williamsu0707/NTOU-UAV-Wind-Measurement-System/Document/Project Report.pdf

# 國立台灣海洋大學

## 通訊與導航工程學系

## 專題研究報告

### 指導教授:莊季高教授

# 不同風速下校園風場數值

# 模擬與實體量測對比分析

## 學生：林哲宇、蘇意為 撰

## 中華民國 114 年 11 月

摘要

### 本研究旨在解決國立臺灣海洋大學理工科系在無人機飛行與應用研究中，對校

### 園微氣候風場數據缺乏經驗證、可靠數值的實務痛點。透過整合數值模擬與高

### 機動性實測，本專題目標為評估 OpenFOAM 搭配 紊流模型在不同風速工況下

### 的預測可靠度，並提供一套實用的模擬基準。

### 在方法論上，我們使用 Blender 和 blosm 插件建立校園建築群的精確幾何模

### 型，並將 yPlus 值處於極高範圍的挑戰，視為硬體限制下的工程取捨。實測部

### 分則採用四軸旋翼無人機搭載高精度感測器，針對 2 級、 3 級、4 級風三種工

### 況，各進行了三次獨立的重複測量，以確保數據的統計嚴謹性與可重複性。

### 結果顯示： 經由空間對齊與 RMSE 相關係數的定量對比，OpenFOAM 模型在

### 中度風速下表現最佳。其中，3 級風工況的模擬數值與實際測量的趨勢相近，

### 證明了模型在宏觀流場趨勢預測上的可參考性。然而，在 2 級風工況下，模擬

### 數值顯著增高，這主要歸因於 RANS 模型的固有局限性以及近壁面 yPlus 極限

### 的影響。

### 本研究結論： 模型在中度風速下具有顯著的工程應用價值。本專題成果為海洋

### 大學理工科系提供了一套經實測校準的 CFD 模擬操作基準，直接降低了無人

### 機飛行優化所面臨的風場未知影響。

### 關鍵詞：OpenFOAM、CFD、無人機量測、k − ω SST 、RMSE、yPlus

目錄

## 圖目錄

## 表目錄

## 第一章 緒論

## 1.1 研究動機

### 在挑選專題時，我們思考了許久遲遲想不到要做什麼主題，在指導教

### 授的建議下，我們找了碩班的學長聊聊，在因緣際會之下我們得知了，原

### 來風場的不同會造成無人機電池的使用時間，也會影響到 PID 的參數，於

### 是我們就想知道有沒有什麼辦法，可以不用每次都去測量風速就能知道實

### 際的風場數值，於是學長跟我們介紹了一個開源軟體 OPENFOAM，它可

### 以很好的模擬及呈現假設風流進來會有什麼樣的變化。

### 但是我們遇到了一個問題，數值模擬的結果並不一定是完全跟現實情

### 況相符的，需要有實際測量的數據來佐證，模擬結果也可能因為模型設定

### 或邊界條件的不同而出現誤差，特別是在建築物密集、氣流變化劇烈的邊

### 界層區域中誤差會變得更為嚴重。因此，我們這項研究的主要目的，就是

### 要了解「模擬」與「實際」之間的差距。

### 我們決定使用 Blender 來建立校園建築的立體模型，接著利用先前提

### 到的 OpenFOAM 進行風場數值模擬，並加入無人機進行風速及風向的測

### 量。透過這樣的方式，我們能得到更加接近現實情況的數據，也能以多風

### 速、多次重複的實測數據來驗證模擬的準確性，進一步了解 OpenFOAM

### 在模擬實際校園環境中的可靠度。最後，我們希望能得到一套經過實測的

### 可信的模擬基準，讓未來進行相關研究時，能把 OpenFOAM 這個程式做為

### 可以信任的模擬軟體，使未來的研究增加一個可以選擇或參考的方式。

### 由於海洋大學的校園鄰近海邊，風場變化快速而且複雜，這讓準確的

### 風場資料顯得特別重要。許多研究領域，像是無人機飛行控制、風能發電

### 設備的部署、大氣污染擴散模擬，都需要比較精確地風速與風向資訊。當

### 風速從二級（輕風）上升到四級（和風）時，氣流的分離位置、渦流形成

### 以及紊流強度也都會有明顯的變化，我們希望能透過這個專題，利用多種

### 風速條件下的實測數據來驗證數值模型，來驗證這種風場模擬方法是不是

### 可信的，為未來的研究提供依據。

## 1.2 研究目的

### 本研究的目的是結合數值模擬與高精確度無人機的實地測量，來評量

### OpenFOAM 在模擬海洋大學校園內特定建築群間，風在不同速度下流動時的準

### 確性，並建立一個可供研究參考的基礎。

### 首先會使用 Blender 軟體，依照實際尺寸建立校園的完整立體建築模型，

### 作為後續 OpenFOAM 模擬的基礎資料。接著在 OpenFOAM 軟體上設定適當

### 的紊流模型與網格策略，設定 2 級、3 級與 4 級風速三種不同情境進行定常

### 流場模擬，取得校園內風速與風向的立體分布結果。

### 為了驗證模擬的可靠度，我們選定了幾棟建築物，在建築物周圍利用無人

### 機在實地實測。無人機會在選定的建築物周圍以 10 公尺為一個級距，在三種風

### 速條件下各進行三次測量，利用搭載的風向風速器收集實際的風場數據，透過

### 樹莓派獲得即時數據，確保結果具有統計代表性。

### 在資料分析時，我們會將模擬結果與三次實測的平均值進行空間上的對

### 應，並透過 均方根誤差（RMSE）、平均絕對誤差（MAE） 以及 相關係數

### （R） 來計算並且以數值來呈現兩者的差異性與一致性。

### 最後，根據比較結果，我們將探討模型在不同風速下的誤差來源，並提出

### 改進 OpenFOAM 模型參數與操作流程的具體建議。希望能將這些成果作為海

### 洋大學理工相關科系的學生們進行風場或微氣候模擬時的參考。

## 1.3 研究材料及方法

### 本研究之研究流程(圖 1)及所使用之主要材料與設備含各項主要元件(圖 2~圖

11):

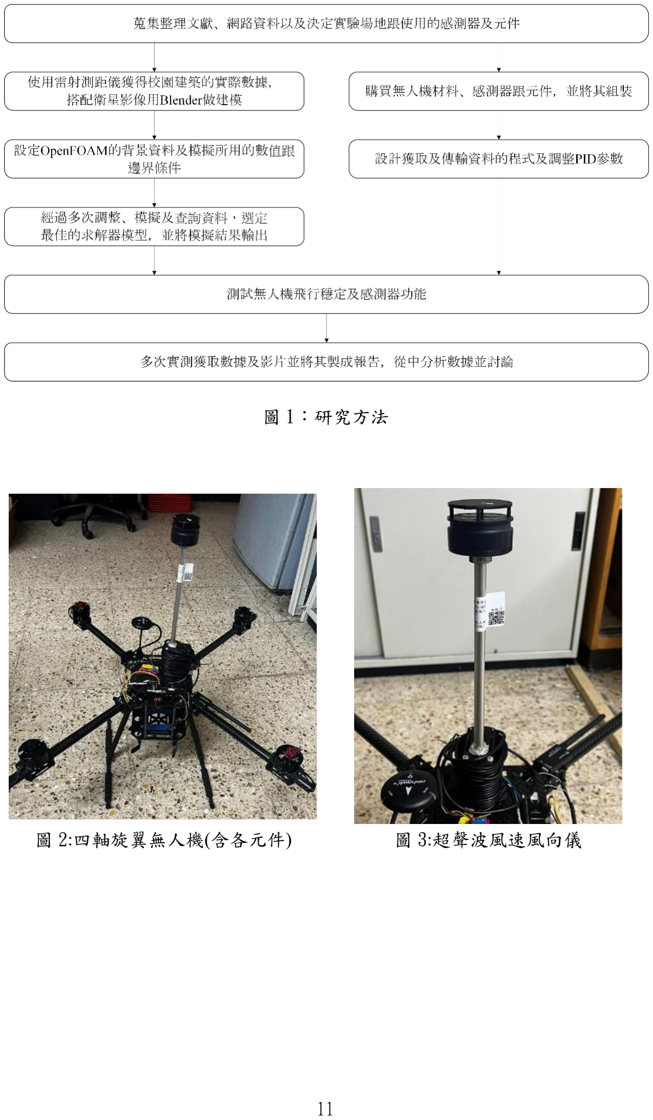
[picture p6: page 11]

### 圖 1：研究方法

圖 2:四軸旋翼無人機(含各元件) | 圖 3:超聲波風速風向儀

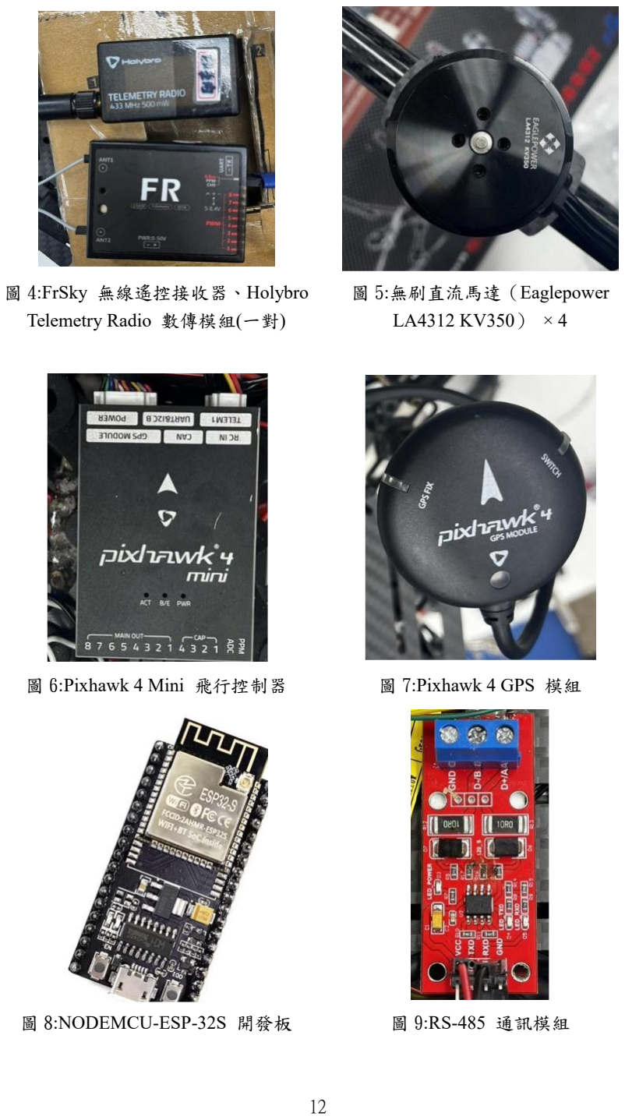
[picture p7: page 12]

圖 4:FrSky 無線遙控接收器、Holybro
Telemetry Radio 數傳模組(一對)

圖 5:無刷直流馬達（Eaglepower
LA4312 KV350） × 4
圖 6:Pixhawk 4 Mini 飛行控制器 | 圖 7:Pixhawk 4 GPS 模組
圖 8:NODEMCU-ESP-32S 開發板 | 圖 9:RS-485 通訊模組

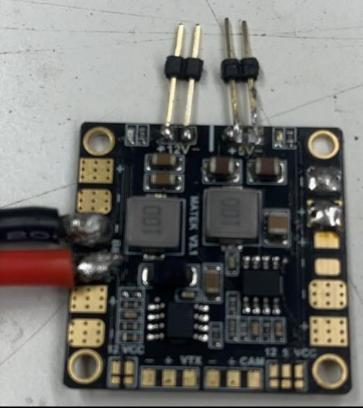
[picture p8: figure]
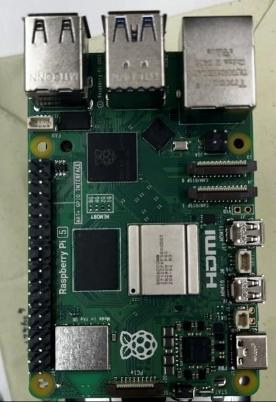
[picture p9: figure]

圖 10:Raspberry Pi 5 | 圖 11:Mini Power Hub(分電板)

## 1.3.1 主要元件規格及其用途:

ESP-32S

### 1. 參數規格[2]

- 模組型號：NodeMCU-32
- 尺寸：25.4mm(W)*48.3mm(H)±0.2mm
- 封裝：DIP-38(2.54 間距標準排針)
- SPI FLASH：默認 32 Mbits
- 支持接口：UART/SPI/SDIO/I2C/PWM/I2S/IR/ADC/DAC
- 頻率範圍：24002483.5λMHz
- 串口速率：支持 300~4608000bps,默認 115200bps
- 藍牙：藍牙 4.2BR/EDR 和 BLE 標準
- SPI Flash：默認 32Mbit,最大支持 128Mbit
- 工作溫度：-20℃70℃
- 存儲環境：-40℃~125℃，<90%RH

### - 供電範圍：

- Micro USB 供電電壓 4.75V5.25V,推薦 5.0V
- 供電電壓 3.0V~3.6V,供電電流>500mA,推薦 3.3V
2. 用途

### - 作為通訊層核心微控制器。

- 透過 MAX485 模組與超音波風速風向儀進行 Modbus RTU 通 訊。

### - 定期以 RS-485 發送查詢指令並接收風速／風向資料。

- 將解析後的資料封裝為 JSON 字串經 UART（115200 bps）傳送

至 Raspberry Pi 5。

### - 作為感測器與主控層之間的資料「轉換節點」。

RS-485 模組

### 1. 參數規格[3] - 晶片具有限擺率驅動程式，減少 EMI，並減少由不恰當的終端匹配 線纜引起的信號反射，從而使無差錯信號傳輸率高達 500Kbps。 - 訊號形式：差動訊號（A / B 線）

- 邏輯電平：TTL（與 ESP-32S UART 電平相容）

### - 具有 1/4 單位負載的接收器輸入阻抗，支援多機通訊，允許接在不 超過 128 個設備的匯流排上 - 工業級晶片工作溫度可以達到-40℃至+85℃。 - 具有電源和 RXD、TXD 信號指示燈

- 支援 3.3V 和 5V 信號控制
2. 用途

### 本研究採用的 RS-485 轉換模組以 MAX485 晶片為核心，用於 將超音波風速風向儀所輸出的 RS-485 差動訊號轉換為 ESP-32S 可 讀取之 UART 電平訊號。由於超音波風速風向儀採用 Modbus RTU 協定，且使用 半雙工 RS-485 作為實體層，因此必須透過 MAX485 進行電氣層介面轉換與方向控制，才能與 ESP-32S 正確通訊。 MAX485 模組之於本系統的用途如下： (1) 進行 RS-485 → UART 電氣層轉換（感測器 → ESP-32S） - 超音波風速風向儀以 RS-485 差動訊號輸出量測資料，ESP-

32S 僅支援 UART（TTL 電平）
- MAX485 負責將 RS-485 A/B 差動訊號轉換為單端 UART 訊 號（RO → ESP-32S RX）
- 同時將 ESP-32S 的 UART 傳送訊號（TX → DI）轉換為 RS-485 差動訊號（A/B）

### - 確保感測資料能在兩種不同電氣標準間正確傳輸 (2) 提供 UART → RS-485 的查詢指令（ESP-32S → 風速儀） ESP-32S 程式碼會主動發送：

node.readHoldingRegisters(0x0001, 1);

### 此指令會：

- 由 ESP-32S 透過 UART TX 輸出查詢封包
- 經 MAX485 的 DI 腳位轉成 RS-485 差動訊號（A/B）

### - 傳送到風速儀（Slave）

因此 MAX485 是 ESP-32S 能進行 Modbus 查詢的必要模組。

### (3) 處理半雙工通訊的方向切換（DE/RE） RS-485 以半雙工方式運作，需要於「傳送模式」與「接收模式」

### 間切換。

MAX485 的 DE/RE 腳位提供此切換功能：

### - DE/RE＝HIGH → 進入傳送模式（主站查詢風速儀） - DE/RE＝LOW → 進入接收模式（等待回應封包） 此機制確保 Modbus RTU 的查詢與回應不互相衝突，是本研究通 訊流程能穩定運作的關鍵。 (4) 提供差動訊號之抗干擾能力，適用於無人機工作環境

- RS-485 差動訊號具備高抗 EMI 能力

### - 可有效抑制無人機上馬達、ESC、高電流線路所產生的噪聲 - 即使在振動與動態電磁干擾環境中，仍能維持穩定、可靠的資 料傳輸 (5) 作為感測層與通訊層之間的訊號穩定化橋接模組

MAX485 負責整合：
- 風速風向儀（RS-485）
- ESP-32S（UART）

### 確保感測資料以正確的電氣格式傳輸至通訊層， 並為後續資料解析與數據封裝提供穩定來源。

Raspberry Pi 5

### 1. 參數規格[4]

- 處理器：Broadcom BCM2712，64 位元四核心 Arm Cortex‑A76，

### 時脈 2.4 GHz，內建加密擴充，每核心 512 KB L2 快取，2 MB 共用 L3 快取。

- 圖形處理器：VideoCore VII GPU，支援 OpenGL ES 3.1 與 Vulkan 1.2，具 800 MHz 時脈，並內建 4Kp60 HEVC 解碼能力。

### - 顯示輸出：雙 HDMI，可支援 4Kp60 螢幕顯示，並具備 HDR 支

援。
- 記憶體：LPDDR4X‑4267 SDRAM，提供 2GB, 4GB, 8GB 和

### 16GB 容量選項。

- 網路無線功能：雙頻 802.11ac Wi‑Fi（Wi‑Fi 5），以及藍牙 5.0／低

### 功耗藍牙（BLE）。 - 儲存與擴充性： - microSD 卡插槽，支援高速 SDR104 模式（效能為前代的兩倍）。 - 提供單條 PCIe 2.0 ×1 插槽，可搭配 M.2 HAT 或其他轉接板，連 接高頻寬外設。

- USB 接口：2 × USB 3.0（同時支援 5 Gbps 傳輸），及 2 ×
USB 2.0。
- 以太網路與 PoE 支援：千兆乙太網路（Gigabit Ethernet），支援

PoE+（需另購 PoE+ HAT）。

### - MIPI 接口：2 × 四通道（4‑lane）MIPI 攝影機／顯示器收發器， 帶寬為先前兩條 1 Gbps 接口的三倍，可支援任意兩個攝影機或顯 示設備組合。

- 電源：5V/5A DC，透過 USB‑C 提供，支援 Power Delivery。
- GPIO：標準 Raspberry Pi 40‑pin 接頭（向後相容）。

### - 其他功能：內建實時時鐘（RTC，需外部電池供電）與電源開關按

鈕
2. 用途
Raspberry Pi 5 在本研究中作為 主控層（Processing Layer）

### 負責 ESP-32S 傳回資料的接收、資料處理、資料記錄與視覺化網頁服 務之提供，是整體系統中最核心的資料管理平台。 (1) 作為主控層資料處理核心

- 以 USB-to-Serial 介面（115200 bps）接收 ESP-32S 所傳送的

### JSON 格式風速／風向資料 - 使用 Python（pySerial）解析每筆資料並存入記憶體緩衝區 - 執行資料有效性檢查（防空讀取、不完整 JSON 濾除） - 將「最新數據」存放於系統共用變數以供網頁查詢 (2) 執行資料統計與長期儲存 Raspberry Pi 5 負責以背景執行緒定期處理感測資料： - 每分鐘計算一次平均風速與平均風向 - 自動建立每日 CSV 檔案（依日期命名） - 儲存完整的時間戳記、平均風速、平均風向資料 - 作為風場長期監測及後續分析之數據來源

(3) 建立即時資料伺服器（Flask Web Server） Raspberry Pi 5 使用 Flask 建立本研究的前端服務：
- /data：提供最新風速（m/s）與風向（°）之 JSON API
- /：提供視覺化網頁（Chart.js）

### - 允許其他裝置透過同網域 IP 直接瀏覽即時資料（例如手機、筆

電）

### 此架構讓使用者可即時查看無人機載測風場之即時資訊。 (4) 提供資料整合與系統管理功能 - 自動偵測本機 IP，顯示系統網址以供快速瀏覽 - 負責管理背景執行緒（感測器輪詢、資料儲存） - 整合感測層與顯示層的所有資料流程 - 作為整個無人機風場量測系統的主要運算平台 (5) 作為感測層與顯示層之間的資料橋接節點

Raspberry Pi 5 扮演資料中樞（Data Hub）角色，負責：

### - 接收來自 ESP-32S（通訊層）的風速／風向資料 - 將資料整理為標準化格式 - 轉換為網路可讀格式（JSON） - 提供瀏覽器端即時視覺化 使整個系統能從無人機端一直到使用者端保持資料同步與一致性。

## 第二章 系統架構設計

## 2.1 系統架構設計

### 本研究所建置之「無人機風場即時量測系統」由感測層、通訊層、主控層 及顯示層組成，其整體架構如(圖 12) 所示。系統架構旨在於無人機飛行過程 中持續獲取風速與風向資料、即時傳輸至地端運算平台，並透過網頁介面進行 視覺化呈現。

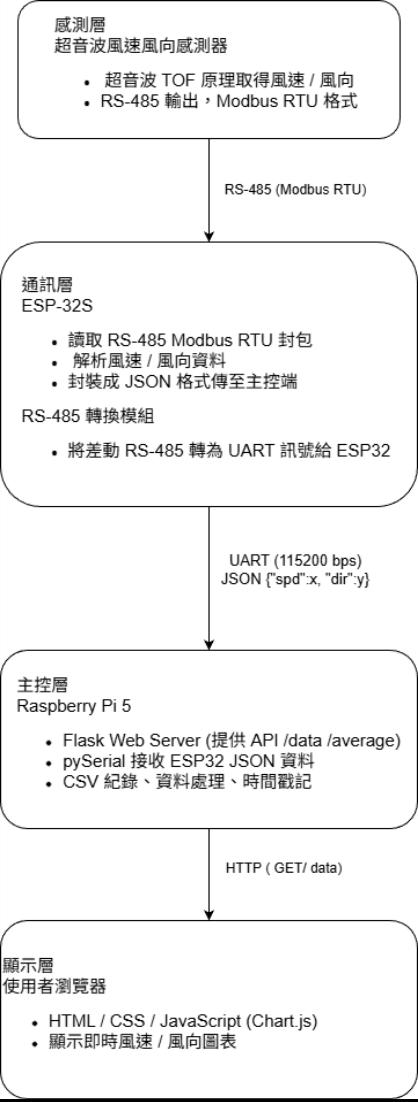
[picture p10: figure]

### (圖 12:系統架構流程圖)

### 2.1.1 感測層

### 感測層使用超音波風速風向感測器 進行環境風場量測，由一顆 4000 mAh 6S 的電池供電。 該感測器採用 超音波飛行時間差（Time of Flight, ToF） 原理，能同時提 供瞬時風速（m/s）與風向（°）資訊，並以 RS-485 介面輸出 Modbus RTU 格 式之資料。 感測器主要規格如下[1]

項目 | 規格內容
量測範圍 | 風速：0–60 m/s；風向：0–359°
量測精度 | 風速：±3%；風向：±3°
分辨率 | 風速：0.1 m/s；風向：1°
感測器尺寸 | 直徑 50 mm；高度 50 mm
重量 | 56 g
輸出介面 | RS-485
通訊協定 | Modbus RTU / ASCII
波特率 | 4800–19200 bps（可設定）
電源需求 | VDC：5-30V； 15mA(12V)
操作溫度/濕度 | −40°C ～ +70°C；0–100 %
工作海拔 | 0–4000 m
安裝方式 | 飛行器頂部立住安裝或底部吊裝
外殼材質 | ABS/黑色

### (表 1：風速計規格)

### 2.1.2 通訊層

### 通訊層負責將感測層取得之風速與風向資料可靠地傳輸至主控層，是本系 統中確保量測資料穩定性與正確性的核心架構。本研究之通訊層由 RS-485 轉 換模組（MAX485） 與 ESP-32S 微控制器 所組成，分別負責差動訊號之電氣 轉換、Modbus RTU 通訊、資料解析與重新封裝等功能。RS-485 模組的供電來 源跟風速儀是同一顆電池供電，由 Mini Power Hub 分電分成 12V 與 5 V 使

用。

### 本研究使用之超音波風速風向儀以 RS-485 差動式訊號並遵循 Modbus RTU 協定輸出資料。由於 ESP-32S 僅支援 UART（TTL 電平），故需透過 MAX485 模組將 RS-485 差動訊號轉換為 UART 單端訊號，使微控制器能正 確讀取感測器之回應封包。

ESP-32S 於通訊過程中擔任 Modbus RTU 主站（Master），定期發送 Function Code 0x03（Read Holding Registers） 之查詢指令，以讀取風速與風向

### 所屬之寄存器資料。查詢前透過控制 MAX485 之 DE/RE 腳位切換至傳送模 式，待封包送出後則切換回接收模式以讀取感測器回應資料。此方向切換機制 為 RS-485 半雙工通訊之必要條件，可確保查詢與回應封包不互相干擾。 ESP-32S 接收到感測器回應後，會解析寄存器內容，並將風速（m/s）與風 向（°）轉換為浮點數格式。解析完成後，ESP-32S 會將資料封裝為 JSON 字

串，並透過模組內建之 USB-to-Serial（USB CDC）介面，以 115200 bps 傳送

### 至 Raspberry Pi 5，由主控層進行後續資料處理與儲存。 之所以選擇 RS-485 作為感測層與通訊層之間的資料傳輸介面，基於以下

原因：

### 1. 較強的抗干擾能力 RS-485 採差動訊號傳輸，具備強大的 EMI 抑制能力，特別適用於無 人機環境中因馬達、電子調速器（ESC）與高電流電源所造成之電磁雜訊。 2. 可靠之長距離與工控等級通訊能力 RS-485 可支援數十至數百公尺的傳輸距離，即使本研究中線長不長， 其高可靠特性仍可確保資料穩定性。 3. 符合 Modbus RTU 之工業標準實體層

風速風向儀採 Modbus RTU 作為通訊協定，而 RS-485 為 Modbus
RTU | 最常見之實體層，有利於減少協定實作複雜度並提高系統穩定
性。

### 4. 降低地電位差與提升電氣安全性

| 差動訊號具備較低電壓擺幅，可有效降低地環路問題並提升系統整

### 體可靠度。 綜合以上設計，本研究通訊層採用

「RS-485（Sensor → ESP-32S）＋ USB Serial（ESP-32S → Raspberry Pi 5）」

### 的雙層資料傳輸架構，兼具工控等級穩定性與即時資料更新能力，確保風速與 風向量測資料能可靠傳遞至主控層。 下圖(圖 13)展示超音波風速風向儀、RS-485 轉換模組（MAX485）、ESP-32S 與 Raspberry Pi 5 之間的電源分配、資料傳遞方向與實體接線關係。無人 機主電池分別供電給 RS-485 模組與風速儀；行動電源提供 Raspberry Pi 運算

電力，而 ESP-32S 透過 USB 與 Raspberry Pi 建立序列通訊並同時獲得 5V 電力。資料自風速儀以 Modbus RTU（RS-485）傳至 ESP-32S，再以 USB Serial 傳至 Raspberry Pi 進行解析與視覺化。

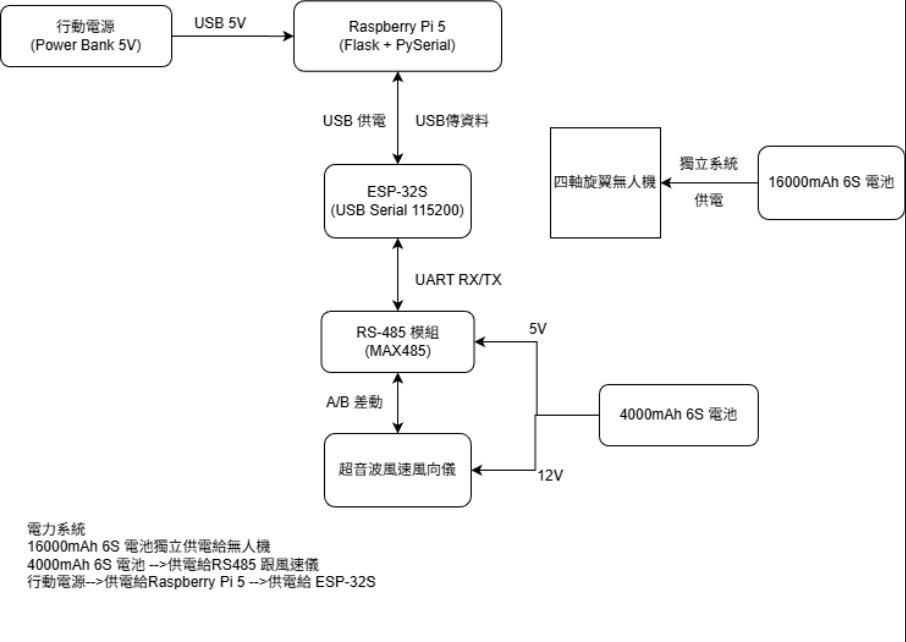
[picture p11: figure]

### (圖 13:硬體接線電力與資料關係圖)

### 2.1.3 主控層

### 主控層由 Raspberry Pi 5 所構成，樹莓派由一顆行動電源供電，負責接收 通訊層所傳遞之風速與風向資料，進行資料解析、緩衝、即時資料更新、統計 計算與資料儲存，並提供資料存取之網路服務。此層整合序列通訊處理、資料 管理與網頁伺服器功能，是整體系統資料整合與呈現的核心單元。

Raspberry Pi 5 透過其 USB 端口與 ESP-32S 連接，並以 USB-to-Serial （USB CDC）方式建立 115200 bps 的序列通訊連線。主控層使用 Python 之

### pySerial 函式庫持續讀取 ESP-32S 所輸出的 JSON 格式資料，並進行解析與 資料驗證。解析成功的資料會即時更新於系統共用變數 last_data 中，並同時推 入採樣緩衝區以供後續統計運算使用。 為避免主程序阻塞與確保資料即時性，主控層採用背景執行緒（Thread） 進行資料輪詢與存檔作業。背景執行緒以高頻率（50 Hz 輪詢）讀取序列埠資 料，並每分鐘自動計算一次平均風速與平均風向。計算結果以 CSV 格式儲 存，依日期自動建立檔案，使系統能進行長期量測紀錄與後續統計分析。

Raspberry Pi 5 並以 Flask Web Framework 建立網頁伺服器，提供資料查詢

### 與前端顯示功能。伺服器提供以下 API： - /data：回傳最新風速（m/s）與風向（°）之 JSON 資料

- /：提供前端視覺化網頁介面（HTML + JavaScript）

### 透過此設計，使用者可於瀏覽器輸入設定好之網址，<樹莓派 IP>:5000 即 可即時查看無人機量測之風場資訊。主控層同時整合 IP 偵測功能，於啟動時 自動顯示本機局域網路 IP，以便使用者快速連線查看資料。 整體而言，主控層負責處理資料接收、解析、平均化、儲存與即時對外服 務等工作，並作為感測層與顯示層之間的資料中樞，使本風場量測系統能於無 人機運作期間提供即時且穩定的風速風向資訊。

### 2.1.4 顯示層

### 顯示層負責將主控層處理後的風速與風向資料以視覺化方式呈現，使使用 者能即時掌握無人機量測到之風場變化。本研究之顯示層採用基於網頁的呈現

方式，主要由 Flask Web Server、HTML 前端介面與 Chart.js 圖表套件所組

### 成。此層提供跨平台、免安裝、低延遲之資料觀測方式，可透過一般桌上型電 腦、筆記型電腦或行動裝置進行查看。 顯示層與主控層之間透過 HTTP 標準介面進行資料交換。Raspberry Pi 5 於主控層中建立 /data API，以 JSON 格式傳送最新風速與風向資料。前端介 面每隔固定時間（約 1 秒）向此 API 發送請求，取得最新風場資訊，並即時 更新於圖表畫面。此方式不需額外安裝應用程式或驅動程式，僅需在瀏覽器中 輸入<樹莓派 IP>:5000 即可使用。

前端視覺化部分由 HTML 與 JavaScript 建構，並使用 Chart.js 作為資料

### 繪圖框架。透過 Chart.js，可將風速變化以折線圖方式即時呈現，而風向資料 則可進行角度轉換後顯示於極座標或儀表式圖形。此視覺化介面可清楚呈現無 人機飛行期間風場的瞬時變化情形，並有助於使用者判讀風況趨勢。

### 顯示層之整體運作流程如下：

1. 前端 JavaScript 定期向 Flask /data API 發送 AJAX 請求

### 2. 主控層回傳最新風速（m/s）與風向（°）資料 3. 前端取得資料後即時更新圖表 4. 使用者透過網頁介面查看風場變化 此架構具備以下優點： - 跨平台性高：可於任何具備瀏覽器的裝置使用 - 即時回饋：資料更新頻率高，延遲極低 - 低成本且易維護：免安裝額外應用程式，部署方式簡單 - 擴充性佳：可新增歷史紀錄查詢、風向玫瑰圖或儀錶板等功能

### 綜合而言，顯示層提供使用者友善且具即時性的視覺化風場數據介面，使 整體系統能有效呈現無人機量測過程中的風速與風向變化情形，並提升系統之 可用性與分析能力。

## 2.2 系統流程

### 本節說明本研究風速風向量測系統自啟動、資料讀取、傳輸、解析、儲存 與視覺化顯示之完整運作流程。系統由感測層、通訊層、主控層與顯示層協同 運作，以確保風場數據能穩定、即時且連續產生。

## 2.2.1 系統啟動與模組初始化

當 ESP-32S 開機後，會首先初始化 USB Serial（供樹莓派接收）、UART2 （用於 RS-485 / Modbus 通訊）、ModbusMaster 物件與 RS-485 方向控制腳位

### （DE/RE）。以下程式碼為 ESP-32S 啟動階段的初始化動作程式碼：

Serial.begin(115200); // 與樹莓派通訊
Serial2.begin(9600, SERIAL_8E1, RXD2, TXD2); // 與風速計通訊：9600, 8E1

node.begin(1, Serial2); // Modbus ID = 1
pinMode(RE_DE, OUTPUT);
digitalWrite(RE_DE, LOW); // 預設為接收狀態
說明：
上述初始化設定包含 USB Serial（115200 bps）、Modbus RTU 參數（9600

### bps、8E1）、RS-485 方向控制腳位設定，確保 ESP-32S 能依序進行查詢與接 收感測器回應。

### 2.2.2 Modbus RTU 查詢流程

### ESP-32S 以 Modbus Master 身分每秒向超音波風速風向儀發送查詢命令 （Function Code 0x03）。研究中讀取的寄存器包含風向（1 寄存器）與風速（2 寄存器）。以下為查詢指令的實際程式碼：

uint8_t result_dir = node.readHoldingRegisters(0x0001, 1);
uint8_t result_spd = node.readHoldingRegisters(0x0002, 2);
說明：

### ESP-32S 傳送查詢時，MAX485 會切換至傳送模式；完成發送後切回接收 模式，以符合 RS-485 半雙工通訊特性。

## 2.2.3 感測器回應資料解析

### 感測器回傳資料後，ESP-32S 需解析寄存器內容。其中風速以兩個 16-bit Word 表示，需組合為 32-bit 浮點數。以下程式碼負責資料解析：

uint16_t high_word = node.getResponseBuffer(0);
uint16_t low_word = node.getResponseBuffer(1);

union {
uint32_t i;

float f;
} u;
u.i = ((uint32_t)low_word << 16) | high_word;
float spd = u.f;
說明：

### 此段程式碼將低位元組（low_word）與高位元組（high_word）組合成

IEEE 754 32-bit 浮點數，並解析出風速數值（m/s）。

### 2.2.4 JSON 打包與 USB Serial 資料傳輸

### 解析完成後，ESP-32S 會將資料封裝為 JSON 格式字串，並經 USB Serial 傳送至 Raspberry Pi 5。以下程式碼負責資料封裝與輸出：

Serial.printf("{\"spd\":%.2f,\"dir\":%.1f}\n", spd, dir); // 標準 JSON
說明：
此 JSON 字串由 Raspberry Pi 端之 pySerial 解析，可直接作為前端資料

### 來源，格式統一且易於網頁處理。

### 2.2.5 Raspberry Pi 端資料接收與緩衝機制

Raspberry Pi 會以非阻塞方式持續讀取 ESP-32S 輸出的 JSON 資料。程

### 式會解析 JSON 並更新最新資料與緩衝區，如下所示：

line = ser.readline().decode("utf-8").strip()
d = json.loads(line)
last_data = {"spd": float(d["spd"]), "dir": float(d["dir"])}
samples.append(last_data)
說明：

### last_data 用於即時顯示；samples 作為 60 秒緩衝區，用於後續平均化計

算。

## 2.2.6 每分鐘平均化與資料紀錄

### 系統每分鐘自動計算平均風速與風向，並寫入 CSV 作為實驗紀錄。以下 為平均化與儲存功能：

avg_spd = sum(d["spd"] for d in samples) / len(samples)
avg_dir = sum(d["dir"] for d in samples) / len(samples)

with open(filename, "a") as f:
w = csv.writer(f)
w.writerow([timestamp, avg_spd, avg_dir])
說明：

### 此機制可產生包含時間戳記的日誌檔案，供後續分析與比對使用。

### 2.2.7 Flask API 資料提供流程

Raspberry Pi 以 Flask 建立 API，前端透過 AJAX 取得最新資料。以下為

### /data 路由之程式碼：

@app.route("/data")
def data():
return jsonify(last_data)
說明：

### 此 API 提供前端每秒即時更新 Chart.js 所需之資料來源。

### 2.2.8 前端資料顯示與 Chart.js 更新流程

### 前端以 JavaScript 每秒向 /data 發送請求，更新圖表。例如：

setInterval(function() {
fetch("/data")
.then(r => r.json())
.then(d => updateChart(d));
}, 1000);
說明：

### 前端會根據最新資料更新折線圖或其他可視化介面，實現即時資料顯示功

能。

## 2.2.9 系統流程總結

### 綜合上述步驟，本研究之資料流程由「感測 → 通訊 → 主控 → 顯示」 構成完整閉環。流程圖可視化呈現於圖 3-X，包含：

- Modbus RTU 查詢
- RS-485 半雙工資料流
- ESP-32S JSON 打包
- USB Serial 傳輸
- Raspberry Pi 資料接收、緩衝與儲存
- Flask API 與前端即時呈現

### 以下流程圖(圖 14)說明系統自 ESP-32S 啟動後，依序完成 Modbus RTU 查

詢、資料解析、JSON 打包、USB Serial 傳輸、Raspberry Pi 解析與儲存，以

### 及透過 Flask 與前端網頁進行即時視覺化之整體資料處理流程。

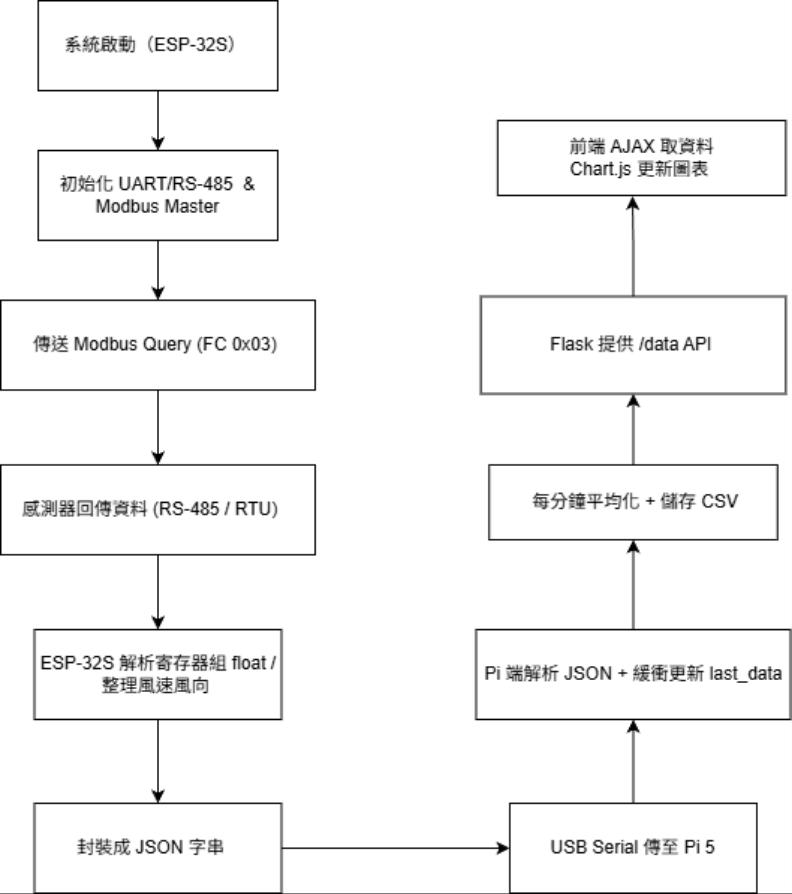
[picture p12: figure]

### (圖 14:完整資料處理流程)

## 2.3 系統實作

### 本節將說明本研究無人機風場量測系統之實際硬體整合與軟體架構實作流 程。硬體部分涵蓋無人機平台、動力系統、感測器與通訊模組之組裝安裝；軟 體部分則包含 ESP-32S 與 Raspberry Pi 5 之程式開發、資料解析與即時顯示功 能。以下將分別介紹硬體與軟體實作內容。

### 2.3.1 硬體實作

### 本研究之風場量測系統建置於四軸旋翼無人機平台。整體硬體整合包含動 力系統、飛控模組、ES P-32S 通訊模組、MAX485 RS-485 轉換模組、超音波 風速風向儀與 Raspberry Pi 5。本節依照實際組裝流程，說明各硬體模組之安裝 方式與整合結果。

### (1) 機體與動力系統組裝

### 無人機採用碳纖材質機架搭配避震機臂，可降低馬達振動傳遞至機體中 央艙位，提升飛控穩定性並避免干擾感測器量測。

動力系統使用 EaglePower LA4312 KV350 無刷馬達，具備高扭力與低

### KV 值特性，適合搭載額外量測模組並維持穩定升力。馬達固定於鋁合金機 臂端部，以螺絲與止滑墊片固定，確保高速旋轉下之結構強度。

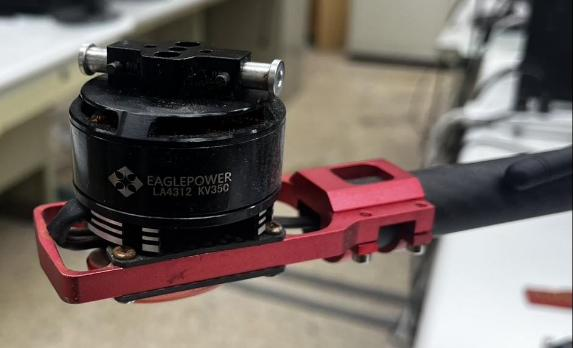
[picture p13: figure]

(圖 15:EaglePower LA4312 KV350 無刷馬達安裝)

### (2) 電子調速器（ESC）配置

本研究採用 Hobbywing XRotor 40A 電子調速器（ESC） 作為無刷馬

### 達之驅動器。ESC 安裝於機臂內側並以熱溶膠固定，三相線連接至馬達 端，而電源線則連接至主電池分電板。此配置可降低阻力干涉，並確保 ESC 在通風環境下正常散熱。

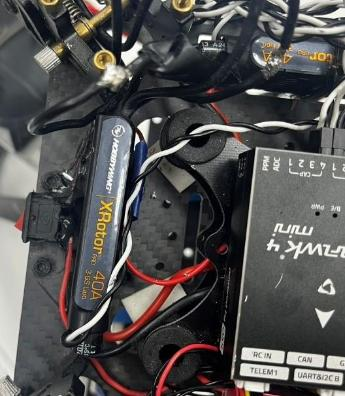
[picture p14: figure]

### (圖 16:ESC 與電線配置示意)

### (3) 飛控模組安裝

### 無人機使用 Pixhawk 4 Mini 作為主要飛控模組，安裝於中央減震板 上，以減震球隔離結構震動，使 IMU 能穩定運作。Pixhawk 與四組 ESC 以 PWM 訊號線連接，同時外接：

- GPS/Compass
- Telemetry 數傳（433 MHz）
- RC 接收器

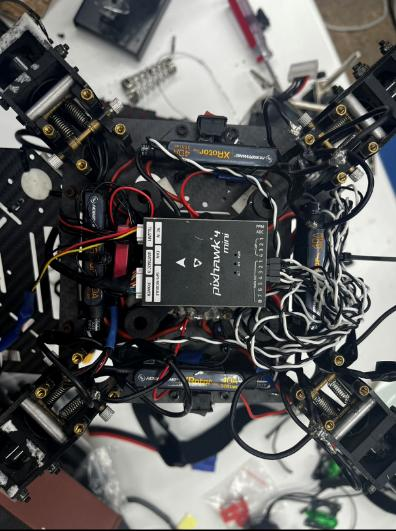
[picture p15: figure]

### (圖 17:飛控安裝示意)

### (4) 電源分配與供電架構

### 本研究之無人機風場量測系統採用三組獨立電源，以提升飛行安全性與 資料量測穩定性。三組電源分別供應動力系統、感測系統與資料處理模組， 各自負責不同子系統，以避免負載干擾與電氣雜訊影響。

### 主動力電池（約 16000 mAh Li-Po）

### 主動力電池為無人機的主要能源，提供高電流供應給四組 ESC 與無刷 馬達，同時透過飛控電源模組（或 ESC BEC）為 Pixhawk 4 Mini 提供穩定 電壓。此電池負責飛行控制與動力輸出，是整體飛行的核心電源來源。

### 感測專用電池（約 4000 mAh Li-Po）

### 本研究另配置獨立 4000 mAh 鋰電池供應：

### - 超音波風速風向儀

- MAX485 RS-485 轉換模組

### - 相關訊號調理電路

### 目的在於避免感測器受到主動力電池電壓變動與 ESC 電磁噪聲（EMI）干 擾，確保 Modbus RTU 通訊穩定性，提高風速與風向量測可靠度。

### 行動電源

### Raspberry Pi 5 由行動電源提供獨立 5V 來源，使其不受主動力電池電 壓下降影響，避免飛行過程中樹莓派因低壓而自動重啟。ESP-32S 透過 USB 與 Raspberry Pi 相連，同時進行資料傳輸與取得 5V 電源。

### 此架構具備以下優點：

- Raspberry Pi 運作更穩定
- ESP-32S 不受動力系統干擾

### - 資料記錄不會因飛行電壓下降而中斷

### 2.3.2 軟體實作

本節說明本研究在 ESP-32S 與 Raspberry Pi 5 上之軟體實作，包括

### Modbus RTU 讀取程式、JSON 資料封裝、USB 串列資料傳輸、後端伺服器建

### 立與前端視覺化介面。整個資料流程如圖 3-2 所示，由 ESP-32S 負責感測資 料讀取與封裝，樹莓派負責資料解析、儲存與網頁顯示。

(1) ESP-32S 資料讀取與 JSON 封裝程式

### ESP-32S 與超音波風速風向儀採用 RS-485 介面通訊，並以

Modbus RTU 協定讀取感測資料。本研究使用 UART2 以 9600 bps、 8E1（8-bit data、Even parity、1 stop bit）與 MAX485 模組溝通。

ESP-32S 程式負責：

1. 初始化 ModbusMaster
2. 控制 RS-485 方向腳位（DE/RE）

### 3. 傳送查詢指令

### 4. 解析寄存器回傳值（風速浮點數、風向整數）

5. 封裝為 JSON
6. 透過 USB 序列埠傳送至 Raspberry Pi

### 下列為本研究使用之 ESP-32S 程式碼之關鍵部分

### 程式碼：

#include <ModbusMaster.h>

// ====== 物件與腳位設定 ======

ModbusMaster node;

#define RE_DE 4 | // RS485 模組 DE/RE 腳位

#define TXD2 17 | // ESP32 UART2 TX

#define RXD2 16 | // ESP32 UART2 RX

// RS485 傳輸前/後的方向控制

void preTransmission() { digitalWrite(RE_DE, HIGH); }

void postTransmission() { digitalWrite(RE_DE, LOW); }

void setup() {

Serial.begin(115200); // 與樹莓派通訊

Serial2.begin(9600, SERIAL_8E1, RXD2, TXD2); // 與風速計通訊：9600, 8E1

node.begin(1, Serial2); // Modbus ID = 1

pinMode(RE_DE, OUTPUT);

digitalWrite(RE_DE, LOW); // 預設為接收狀態

node.preTransmission(preTransmission);

node.postTransmission(postTransmission);

delay(1000);

Serial.println("✅ ESP32 風速計啟動完成，開始傳送資料...");

}

void loop() {

float spd = NAN;

float dir = NAN;

// ====== 讀取風向（地址 0x0001, 寄存器數量 1）======

uint8_t result_dir = node.readHoldingRegisters(0x0001, 1);

if (result_dir == node.ku8MBSuccess) {

dir = node.getResponseBuffer(0);

}

// ====== 讀取風速（地址 0x0002, 寄存器數量 2）======

uint8_t result_spd = node.readHoldingRegisters(0x0002, 2);

if (result_spd == node.ku8MBSuccess) {

uint16_t high_word = node.getResponseBuffer(0);

uint16_t low_word = node.getResponseBuffer(1);

// 正確順序：低位在前

union {

uint32_t i;

float f;

} u;

u.i = ((uint32_t)low_word << 16) | high_word;

spd = u.f;

}

// ====== 防呆與輸出 JSON ======

if (!isnan(spd) && !isnan(dir)) {

Serial.printf("{\"spd\":%.2f,\"dir\":%.1f}\n", spd, dir); // 標準 JSON

} else {

Serial.println("{\"spd\":0,\"dir\":0}"); // 若讀取失敗則回傳 0

}

delay(1000); // 每秒輸出一次

}

### 功能說明：

### - ModbusMaster 套件初始化：設定裝置位址、通訊介面與校驗方式

### - RS-485 DE/RE 控制：確保發送與接收方向正確

- 寄存器讀取：0x0001 為風向；0x0002~0x0003 為浮點數風速

### - 浮點數合併：Modbus 回傳兩組 16-bit，程式需重新組合成 float

- JSON 輸出：每秒產生 {"spd": x, "dir": y} 資料
- USB Serial 傳輸：ESP-32S 經由 USB 送至 Raspberry Pi 進行處理與顯示
(2) Raspberry Pi 5 串列接收與資料處理程式

Raspberry Pi 5 透過 pySerial 以 115200 bps 接收 ESP-32S 輸入之 JSON 字串。

### 後端程式負責：

1. 解析 JSON

### 2. 更新最新資料

### 3. 累積每分鐘的風速／風向樣本

### 4. 每分鐘計算平均值

5. 寫入 CSV
6. 提供 Flask API 供前端介面讀取

7.

Raspberry Pi 資料接收與處理程式（Python）

### 程式碼：

# ==============================

# 風速風向 Flask Server（完整穩定版）

# ==============================

from flask import Flask, render_template, jsonify

import serial, json, time, csv, os, threading, socket

from datetime import datetime

app = Flask(__name__)

# ---------- 串口設定 ----------

# 依你目前環境：ESP32 用 /dev/ttyUSB0，115200

# 若不同可改成 /dev/ttyACM0 或 Windows 的 COMx

SERIAL_PORT = os.environ.get("WIND_SERIAL", "/dev/ttyUSB0")

BAUD = 115200

ser = None

def _open_serial():

global ser

try:

ser = serial.Serial(SERIAL_PORT, BAUD, timeout=1)

print(f"✅ Serial opened on {SERIAL_PORT} @ {BAUD}")

except Exception as e:

ser = None

print(f"❌ Serial open failed: {e}")

_open_serial()

# ---------- 全域資料 ----------

last_data = {"spd": 0.0, "dir": 0.0}

samples = []

data_lock = threading.Lock()

# ---------- 工具：取得本機 IP ----------

def get_ip():

try:

s = socket.socket(socket.AF_INET, socket.SOCK_DGRAM)

s.connect(("8.8.8.8", 80))

ip = s.getsockname()[0]

s.close()

return ip

except:

return "127.0.0.1"

# ---------- 感測資料讀取（單筆） ----------

def read_one():

global last_data, ser

if ser is None or not ser.is_open:

_open_serial()

return

try:

line = ser.readline().decode("utf-8", errors="ignore").strip()

if not line:

return

# 僅接受完整 JSON

if not (line.startswith("{") and line.endswith("}")):

# print("⚠️ 忽略不完整資料:", line)

return

d = json.loads(line)

if "spd" in d and "dir" in d:

with data_lock:

last_data = {"spd": float(d["spd"]), "dir": float(d["dir"])}

samples.append(last_data)

# else:

# print("⚠️ JSON 缺少欄位:", d)

except json.JSONDecodeError:

# print("❌ JSON decode failed:", line)

pass

except Exception as e:

print("❌ read_one error:", e)

# ---------- 每分鐘平均存檔 ----------

def save_average():

global samples

with data_lock:

if not samples:

return

avg_spd = sum(d["spd"] for d in samples) / len(samples)

avg_dir = sum(d["dir"] for d in samples) / len(samples)

samples = []

if not os.path.exists("data"):

os.makedirs("data")

filename = f"data/wind_{datetime.now().strftime('%Y-%m-%d')}.csv"

write_header = not os.path.exists(filename)

with open(filename, "a", newline="") as f:

w = csv.writer(f)

if write_header:

w.writerow(["timestamp", "avg_speed(m/s)", "avg_direction(deg)"])

w.writerow([datetime.now().strftime("%Y-%m-%d %H:%M:%S"),

round(avg_spd, 2), round(avg_dir, 1)])

print(f"📦 Saved avg: {avg_spd:.2f} m/s, {avg_dir:.1f}°")

# ---------- 感測讀取背景執行緒 ----------

def sensor_loop():

last_save = time.time()

while True:

read_one()

if time.time() - last_save > 60:

save_average()

last_save = time.time()

time.sleep(0.02) # 50Hz 輕量輪詢

# ---------- Flask 路由 ----------

@app.route("/")

def index():

return render_template("index.html") # templates/index.html

@app.route("/data")

def data():

with data_lock:

d = dict(last_data)

return jsonify(d)

# ---------- 入口 ----------

if __name__ == "__main__":

ip = get_ip()

print(f"🌐 Open http://{ip}:5000（你的 IP 是 {ip}，你提供的是 172.20.10.6 也可以）")

### # 啟動感測背景執行緒

threading.Thread(target=sensor_loop, daemon=True).start()

### # 啟動 Flask（對外可訪問）

app.run(host="0.0.0.0", port=5000, debug=False)

### （3）Flask 前端即時顯示介面

Raspberry Pi 5 執行 Flask 伺服器，前端網頁使用 JavaScript 以固定

### 週期請求 /data API，並更新頁面上的風速（m/s）與風向（°）資訊。 此設計可於無網路環境下直接透過樹莓派提供的 Wi-Fi 或區域 IP 進 行監看。

### 前端網頁結合：

- AJAX 資料請求
- Canvas 或 SVG 即時指標顯示
- m/s 與 degree 數值更新
- 簡潔 UI

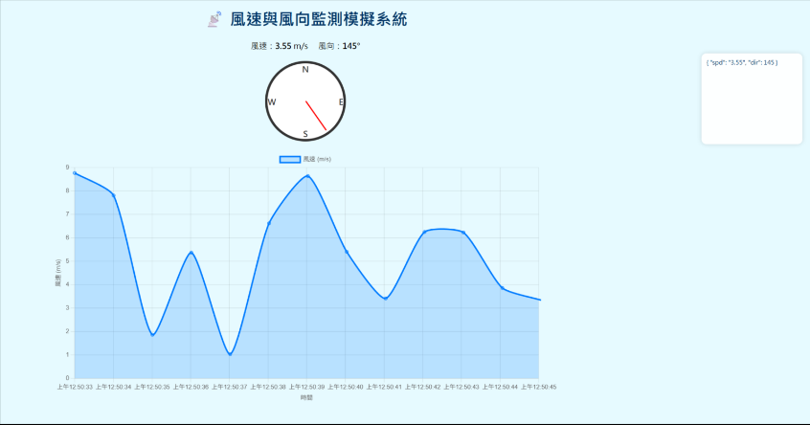
[picture p16: figure]

### (圖 18:前端網頁模擬圖)

## 2.4 系統測試與驗證

### 本節針對本研究所建立之無人機風場量測系統進行功能性與穩定性測試， 驗證 RS-485 通訊、感測資料讀取、USB 資料傳輸、後端伺服器運作及即時前 端顯示功能是否符合需求。測試內容包含通訊層驗證、資料完整性驗證、系統 穩定度測試以及實際量測功能驗證。

### 2.4.1 RS-485 通訊測試

### 為確認 ESP-32S 能正確與超音波風速風向儀進行 Modbus RTU 通訊，本研 究於地面進行 RS-485 層級之初步驗證。 測試步驟如下：

1. 將 ESP-32S 與 MAX485 模組連接風速風向儀之 RS-485 A/B 端子
2. 設定 UART2 通訊參數為 9600 bps、8E1

3. 以 ModbusMaster 套件發送 Holding Register 查詢指令
4. 監看風向（0x0001）與風速（0x0002~0x0003）是否成功回傳

### 測試結果顯示 ESP-32S 能穩定取得感測器資料，且查詢周期為 1 秒時無封包 遺失情形。此結果證實本系統之 RS-485 實體層與 Modbus RTU 通訊協定均能 正常運作。

### 2.4.2 ESP-32S JSON 封裝與 USB 資料傳輸測試

### 確認 RS-485 通訊正常後，本研究進一步驗證 ESP-32S 將讀取結果封裝

為 JSON 字串並透過 USB 傳送至 Raspberry Pi 之運作情況。

### 測試內容包含：

### - JSON 格式完整性（是否每秒產生合法字串）

### - USB 連線持續性（長時間運作是否會中斷）

- 樹莓派端 pySerial 解碼驗證

### 測試結果顯示：

### - ESP-32S 能以固定頻率輸出格式正確的 JSON，如：

{ "spd": 1.24, "dir": 85.0 }

### - USB 傳輸穩定，可連續運行多小時未出現斷線

### - 樹莓派能完整接收並解析每筆資料

此結果證實 ESP-32S → USB → Raspberry Pi 之資料路徑運作正常。

## 2.4.3 後端伺服器與資料處理功能驗證

### 為驗證 Raspberry Pi 5 上 Flask 後端之資料處理流程，本研究進行以下測

試：

### （1）即時資料更新測試

- 執行 python server.py 後，樹莓派成功啟動 Flask 伺服器
- 前端頁面於 /data API 每秒取得最新 JSON

### - 當風速儀改變方向或風速時，前端可立即更新數值

### （2）資料緩衝與平均化測試

- 樹莓派每 60 秒統計 samples 緩衝區

### - 計算風速與風向平均值

### - 每分鐘寫入 CSV

### 測試結果顯示 CSV 中之時間戳與平均值均與實際量測相符。

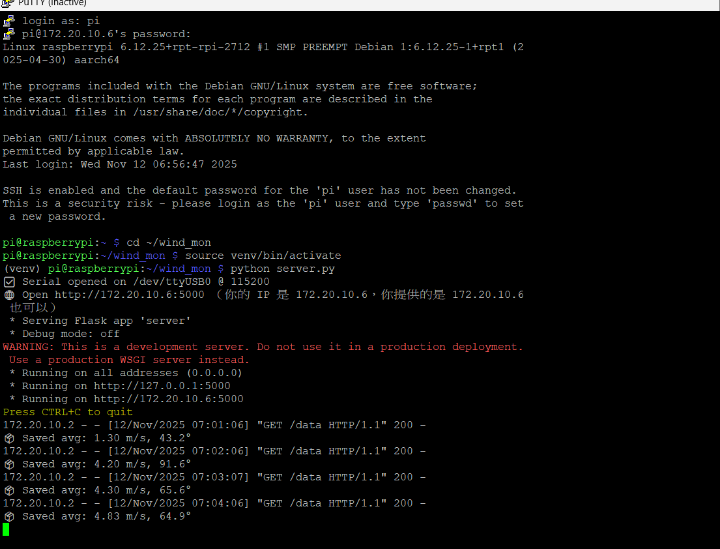
[picture p17: figure]

(圖 19:Raspberry Pi 5 啟動 server.py)

### 2.4.4 CSV 資料寫入測試

### 為確認資料可長期保存，本研究執行以下流程：

### 1. 連續運作系統 20 分鐘

### 2. 每分鐘生成一筆平均風速與風向資料

3. 開啟 data/wind_YYYY-MM-DD.csv 驗證格式

### 測試結果如下：

### - CSV 檔案成功建立

- 格式正確（timestamp, avg_speed, avg_direction）

### - 20 分鐘內共產生 20 筆平均資料

### - 未發生寫入錯誤或檔案損毀

### 此結果驗證資料長期記錄功能可靠。

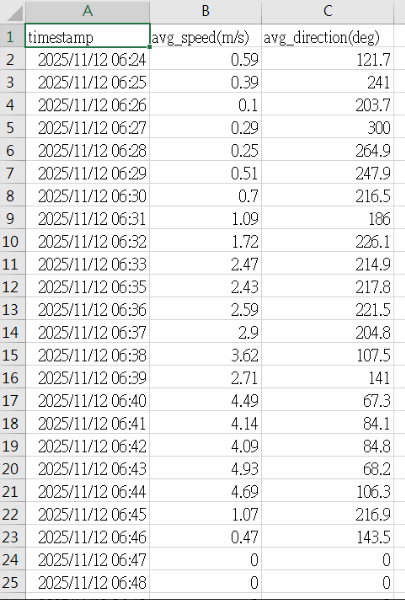
[picture p18: figure]

### (圖 20:確實建立 CSV 檔以及每分鐘的平均數據)

## 2.4.5 前端顯示功能測試

### 為確保整體系統能於飛行條件下長時間運作，本研究進行 30 分鐘連續地面運作

測試：

⚫ | RS-485 通訊無封包遺失
⚫ | USB 無斷線
⚫ | Flask 仍能正常提供 API

⚫ | CSV 寫入正常、檔案未損毀
⚫ | ESP-32S 與 Raspberry Pi 無重新啟動情形

### 結果顯示本系統具備足夠穩定性，可支援長時間風場量測。

## 第三章 研究方法與實驗設計

## 3.1 校園 CFD 建模與數值設定

### 本小節旨在詳細闡述將實際校園建築群轉化為 CFD 可運算模型的整個流程。 內容涵蓋了幾何模型建立的數據基礎與處理(Blender、blosm、實測數據整合）， 網格生成的品質控制，以及 OpenFOAM 數值模型的邊界條件與紊流參數 設定。 這些步驟是確保 CFD 模擬具備物理有效性和數值穩定性的前提。

## 3.1.1 校園幾何模型建立

### 本研究利用 Blender 軟體作為 CFD 幾何模型的前處理工具，其優勢在於能精確 處理複雜的多邊形網格，並提供高度的自定義屬性 [7]。幾何模型建立流程結合 了實地測量及衛星數據，具體流程如下:

### 1. 位置與間隔重建:

### 整體校園建築群的相對位置與間隔，是透過開源 GitHub 配件程式

（Add-on，blosm[8]）收集 GoogleMap 的衛星影像數據，並將其自動匯入

### Blender 中進行初步的平面對齊與地貌重建。

### 2. 尺寸精度確立:

### 雖然利用衛星數據提供了位置，但建築物實際的長、寬、高尺寸精

### 度，則透過雷射測距儀進行實地量測 ，以確保模型在垂直方向上的尺寸

### 準確性。

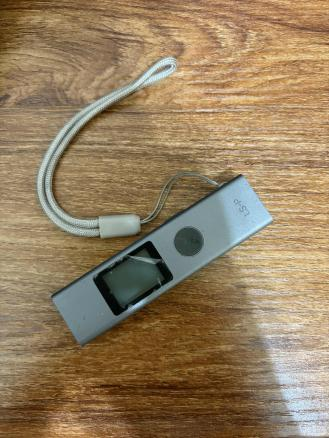
[picture p19: figure]

### (圖 21:雷射測距儀)

### 3. 模型簡化:

### 由於 CFD 網格計算資源有限，我們基於模型簡化原則[9]。所有對流

### 場影響極小的細節物件（如欄杆、植被群等）均被移除。並且利用

### Blender 工具對所有建築物底座、屋頂邊緣進行修復和清理，以消除幾何

### 瑕疵（如「非流形邊緣」），解決後續 OpenFOAM 網格生成時遇到的

### 「爆點」問題[10]，確保輸出的 STL 檔案能有效的模擬風場(圖 22)。

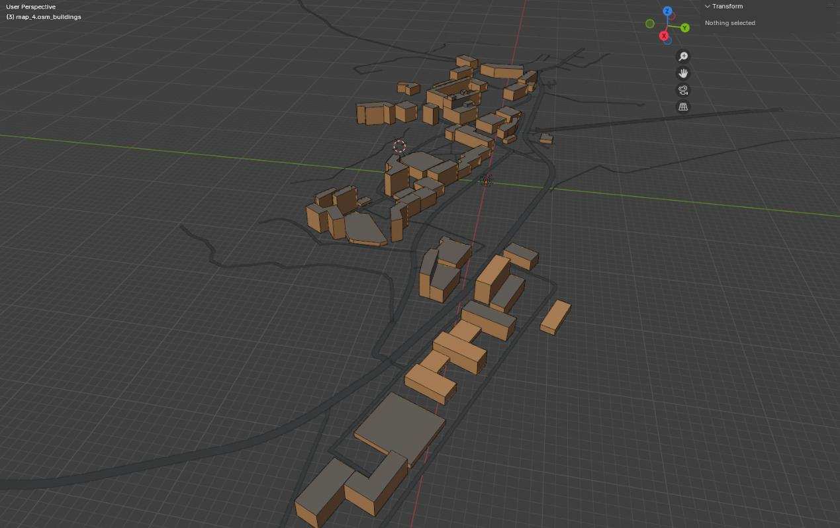
[picture p20: figure]

### (圖 22:海洋大學的校區模擬模型)

## 3.1.2 數值網格生成與品質控制

### 網格生成在 CFD 模擬中非常的重要，會直接影響到計算結果的精度和收斂

### 速度[11]，我們採用了 OpenFOAM 中用來處理複雜幾何的網格生成器

snappyHexMesh 來進行六面體的網格生成。

### (1.)網格生成策略

### 1.網格品質調整：

### 如先前所述，網格品質問題是本研究中最棘手的環節。 由於 Blender 輸出

### STL 檔案中會潛藏非流形邊緣，容易導致網格生成器在邊界處難以生成有效單

### 元，我們透過不斷的幾何修復與參數調整，才最終獲得了穩定的網格。

### 2. 網格規模與品質：

### 最終採用的總網格單元數為 237600 個。這個數量是受到個人電腦計算

### 資源限制與流場解析度的考量之後的選擇。

### 此模型的網格的最大非正交性為 64.9977(圖 23)，遠低於 CFD 普遍接受

### 的 70 上限[12]。這個數值能代表了幾何前處理是非常成功的，並為後續

### 的數值收斂提供保障。

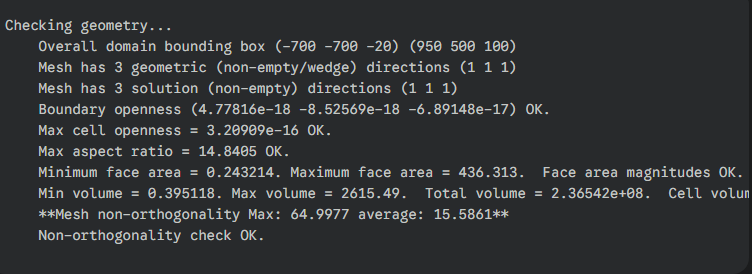
[picture p21: figure]

### (圖 23:模擬輸出的部分內容)

### (2.)邊界層網格解析與處理

### 邊界層網格的解析是 CFD 模擬精度的核心。本研究採用 k − ω SST 紊流模型

### 並結合標準壁函數進行計算，理論上要求壁面 y

### + 值需控制在 30 至 100 的範

### 圍內，然而，受限於專題的計算硬體規格與總網格數量 237600 我們無法在建築

### 物壁面部署足夠細緻的邊界層網格。在運行收斂模擬後，實際量測到的 y

+ 範

### 圍如下：

- 最小值：63734.3
- 最大值：83639.1
- 平均值：71428.6

(圖 24:yPlus 輸出數值)

### 工程取捨與有效性：

### 顯然，這個 y

### +範圍遠超過標準壁函數的適用上限。這證明了我們的 CFD 模

### 型無法完整模擬建築物貼近壁面的黏滯流動。本研究將此視為在資源限制下，

### 必須接受的工程取捨，我們將有限的網格資源集中於宏觀流場和建築物尾流區

### 的捕捉，放棄了對近壁面摩擦力的精確計算。因此，本專題的模擬結果應被理

### 解為：在簡化的近壁條件下，對校區宏觀氣流趨勢的評估。

### 重要性： 這個 y

### + 值將會被納入為第四章誤差分析中的誤差來源，用於解釋

### CFD 模擬值與無人機實測值之間的部分偏差。

### 3.1.3 OpenFOAM 數值模型與邊界條件

### 本研究使用 windy 軟體所提供的氣象風速作為輸入，並採用 RANS(Reynolds-

### Averaged Navier-Stokes)方法進行數值模擬。此方法旨在計算流場的平均特性，

### 以在有限的計算資源下提供穩定的工程評估結果。

### (1.)求解器與紊流模型設定

### 1.求解器：

### 採用 OpenFOAM 中處理穩態不可壓縮流動的 simpleFoam 求解器。該

求解器使用 SIMPLE(Semi-Implicit Method for Pressure-Linked

### Equations)算法處理壓力與速度的耦合。

### 2.紊流模型：

核心紊流模型選用k − ω SST (Shear Stress Transport)[13]。

3.優勢：

### k − ω SST 模型透過混合函數，在邊界層內使用k − ω 模型以提升近壁

### 面的精度，在自由流場中轉換為 k − ε 模型以確保數值穩定性，是模擬建

築物周圍流動分離(Flow Separation)和尾流區(Wake Region) 的最佳工程選

擇之一 [14]

### 4.收斂判據：

### 數值收斂標準設定為所有物理量（速度 U、壓力 p、紊流動能 k、紊

### 流耗散率ω ）的殘差均收斂至10⁻⁴ 以下。此外，計算域出口的風速監測點

### 變動幅度需小於 1% 時，才判定為穩定收斂。

## 3.1.4 邊界條件設定與多工況設計

### 本專題針對 2 級、3 級、4 級風三種工況進行模擬。入口的紊流動能(k)與

### 紊流耗散率(ω )是根據紊流強度(I= 0.1)和混合長度 (L = 0.07) 公式計算得出

[15]。

邊界條件 | 參數 | 2 級風工況 | 3 級風工況 | 4 級風工況
速度(U) | Uref(m⁄s) | 3.0 | 5.0 | 7.0
紊流動能(k) | kinlet(m² 2 ⁄ ) s | 0.135 | 0.375 | 0.735
紊流耗散率(ω ) | ωinlet(1⁄s) | 59.390 | 97.940 | 137.116
壓力(p) | 出/入口條件 | 零梯度 | 零梯度 | 零梯度
壁面(wall) | 條件 | 標準壁函數 | 標準壁函數 | 標準壁函數

### (表 2：三種風級工況的 OpenFOAM 入口邊界條件)

### (1) 壁面與其他邊界條件

### 1. 壁面條件：

### 建築物與地面壁面採用無滑移條件(No-slip)，並結合標準壁函數

(Standard Wall Function)來處理近壁紊流。我們必須指出，由於 y

+值超

### 出理想範圍，這項設定是本專題在有限的資源限制下對近壁面精度限制

### 的工程取捨。

### 2. 其他邊界：

### 出口採用零梯度壓力條件(Zero Gradient)，計算域頂部及側面則採用

### 對稱或滑移壁面條件。

## 3.2 無人機實測系統與數據採集

### 本研究的實測部分採用無人機作為高機動性的移動氣象平台，針對 CFD

### 模擬區域進行數據採集。

## 3.2.1 無人譏平台與感測器集成

### 實測部分採用無人機作為高機動性的移動氣象平台。我們選擇 四軸旋翼無

### 人機作為載具，其優勢是固定翼無人機難以取代的：

### (1.)定點懸停與精確定位：

### 四軸旋翼具備卓越的垂直起降與定點懸停能力。這項優勢是滿足本

### 專題對 CFD 網格中的特定空間坐標進行長時間(60 秒)穩定採集，以實現

### 時間平均化處理的關鍵前提。

### (2.)複雜環境下的機動性：

### 載具擁有高機動性與精確定位能力，使得我們能夠在建築物周圍獲

### 取風場的數據。

### (3.)集成設計與擾流處理：

### 為確保數據真實性，感測器於無人機中央處，用垂直的方式安裝，以

### 最大程度地讓感測器遠離螺旋槳產生的下洗氣流。所有採集數據以每秒的

### 實時風速做一分鐘的總平均，並結合機載 GPS/IMU 數據，用於後續的飛行

### 姿態校正。

## 3.2.2 實驗設計流程及地點選擇

### 本研究為了確認 CFD 模型可靠程度且獲得具有代表性的驗證數據。我們的

### 實驗著重於較常遇到的風速工況與數據的統計信賴度。

### (1.)實測工況設定：

### 實測地點選定於延平大樓、生命科學園區、工學院外圍草皮，這些區域涵

### 蓋了全校的範圍來驗證校園整體模擬真實性。我們依據 CFD 模擬的邊界

### 條件，鎖定三種典型風級進行實測，以檢驗模型在不同紊流強度下的性

能：

### - 輕風工況 (2 級風)：Uref ≈ 3.0 m⁄s

### - 微風工況 (3 級風)：Uref ≈ 5.0 m⁄s

### - 和風工況 (4 級風)：Uref ≈ 8.0 m⁄s

### (2.)重複性設計：

### 為了確保數據的統計嚴謹性，針對每一種風級，我們各執行三次獨立的重

### 複測量（共 9 組實驗）。這種設計讓我們能夠計算出實驗之間的最終標準差

### σfinal，這是證明實測數據可重複性的關鍵指標[16]。

## 3.2.3 飛行路徑與數據採集策略

### (1.)測量區域與目的：

### 飛行路徑的設計旨在最大化採集數據的驗證價值。我們在相同風速

### 風向下，在三個相對下容易收集的區域位置收集數據，以保證數值的可

### 參考性。

### (2.)採集模式：

### 數據採集採用垂直剖面懸停模式。在每個測量點位(10m、20m、

### 30m、40m)，無人機將定點懸停(60s)進行高頻數據採集。此 60 秒的採樣

### 長度足以進行時間平均化處理，以對應 RANS 模型計算出的定常平均流

場[18]。

### (3.)飛行點位圖：

### 實測點位的分布將呈現於下圖中(圖 25~圖 27)。

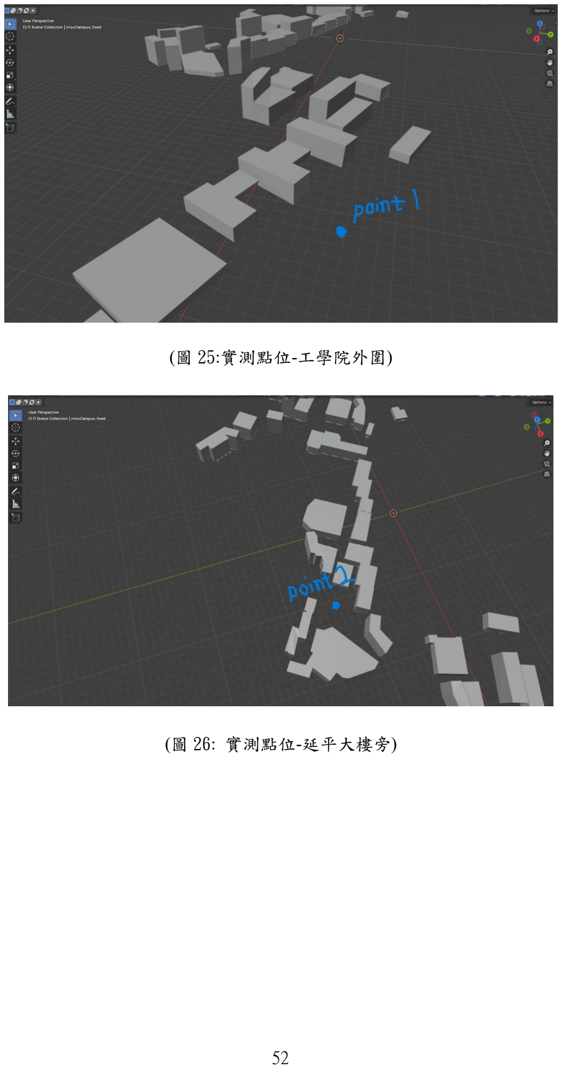
[picture p22: page 52]

### (圖 25:實測點位-工學院外圍)

### (圖 26: 實測點位-延平大樓旁)

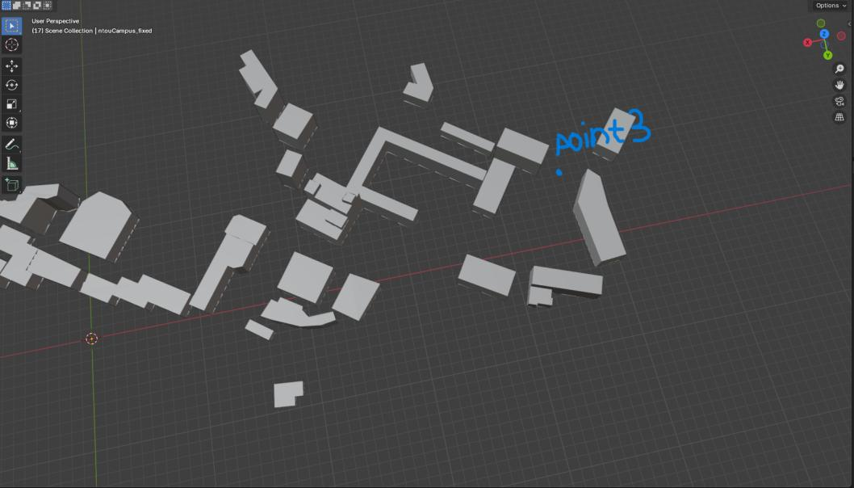
[picture p23: figure]

### (圖 27: 實測點位-生科院旁)

## 3.3 數據處理與定量對比方法

### 本專題的驗證流程核心在於確保 CFD 模擬的定常平均流場，能與無人機實

### 測的瞬態數據進行嚴謹且有效的定量對比。數據處理與對比分為以下三個階

段：

## 3.3.1 無人機數據前處理與平均化

### 為將瞬態實測數據轉化為可與 RANS 模型對比的平均值，我們採用了平均化步

驟：

### (1.)數據對時間平均：

### 首先，對所有採集到的數據進行姿態角校正，消除無人機自身微小姿態變

### 化帶來的誤差。接著，計算每個點位 60 秒懸停期間的平均風速(νi )與瞬時波動

(σi

### )，其中σi反映了該點風場的紊流強度。

### (2.) 實驗重複平均：

### 針對同一風級狀況下的三次獨立實驗結果(ν1、ν2、ν3)，我們計算其最終平均風

速(νfinal

### )，作為與 CFD 結果對比的最終實測值。同時計算這三個平均值之間的

### 最終標準差，這個是我們證明實驗設計可重複性的關鍵指標，將用於在圖表中

### 繪製誤差圖。

## 3.3.2 定量誤差指標計算

### 數據對齊後，我們將採用以下兩種標準指標，對每個風級工況的 CFD 預測

### 精度進行定量評估：

(1.) 均方根誤差(RMSE)：

### 用於量化模擬風速νsim與實測平均值 νfinal之間的平均偏差。

### RMSE = √

1
N

∑ (Vsim,i − Vfinal,i)

2 N
| i=1

[式-1]

(2.)相關係數(R) ：

### 採用 Pearson 相關係數，評估模擬數據與實測數據在變化趨勢上的一致。

R =

∑ (Vsim,i−Vsim)(Vfinal,i−Vfinal)

N
i=1
√∑ | (Vsim,i−Vsim)
2 ∑ | (Vfinal,i−Vfinal)

2 N
N | i=1
i=1

[式-2]

## 第四章 實驗結果與討論

## 4.1 CFD 數值模擬結果展示

### 本小節旨在呈現 OpenFOAM 數值模型在三種典型風級工況下所計算出的宏

### 觀流場結構。這些模擬結果是本專題進行無人機實測數據對比的理論基準。所

### 有結果均基於 3.1 節所定義的計算參數和 3.3 節所設定的入口邊界條件。我們

### 將首先從宏觀角度解析風場的關鍵特徵，例如迴流區、加速區與流線分佈，為

### 後續 4.4 節的實驗結論及建議奠定基礎。

## 4.1.1 三級風下各點位風場數值

### 三種風速下各點位風速圖與實測點數值如下圖所示:

(1.)2 級風(3m/s):

1.10 公尺

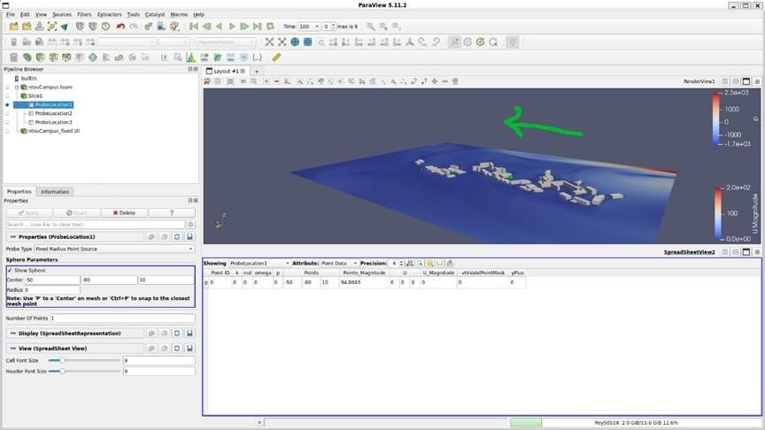
[picture p24: figure]

### (圖 28:延平大樓旁風速圖)

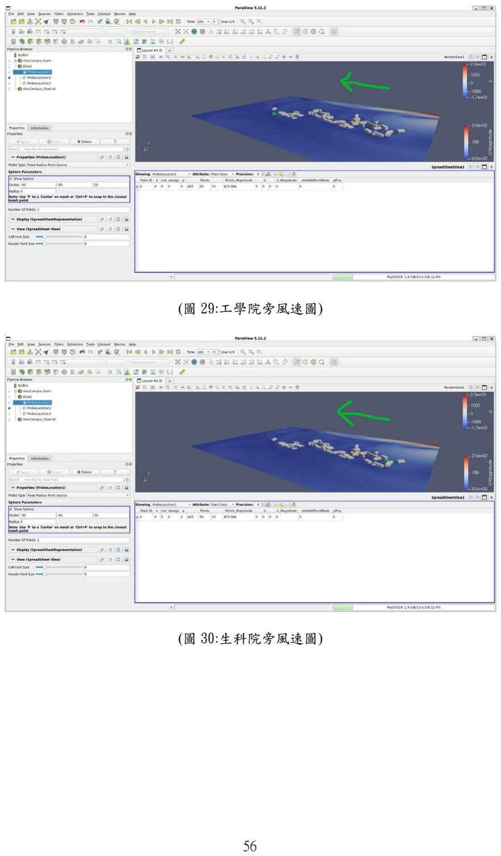
[picture p25: page 56]

### (圖 29:工學院旁風速圖)

### (圖 30:生科院旁風速圖)

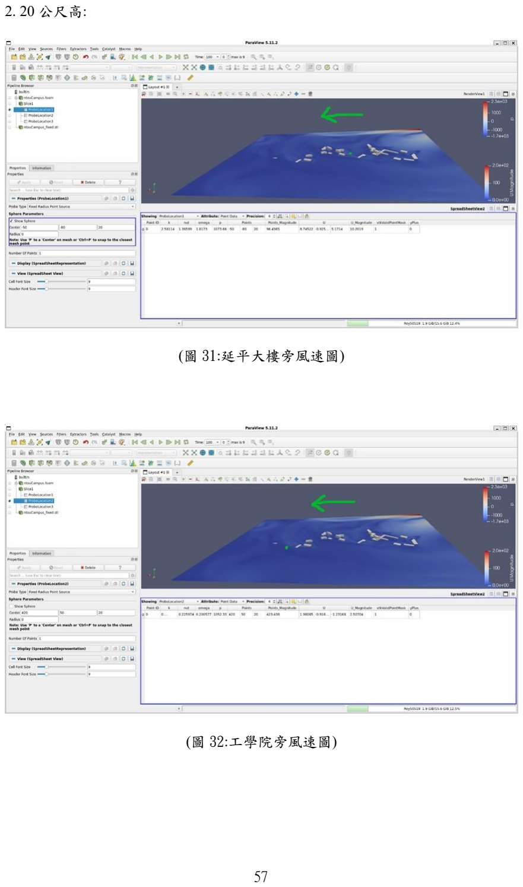
[picture p26: page 57]

2. 20 公尺高:

### (圖 31:延平大樓旁風速圖)

### (圖 32:工學院旁風速圖)

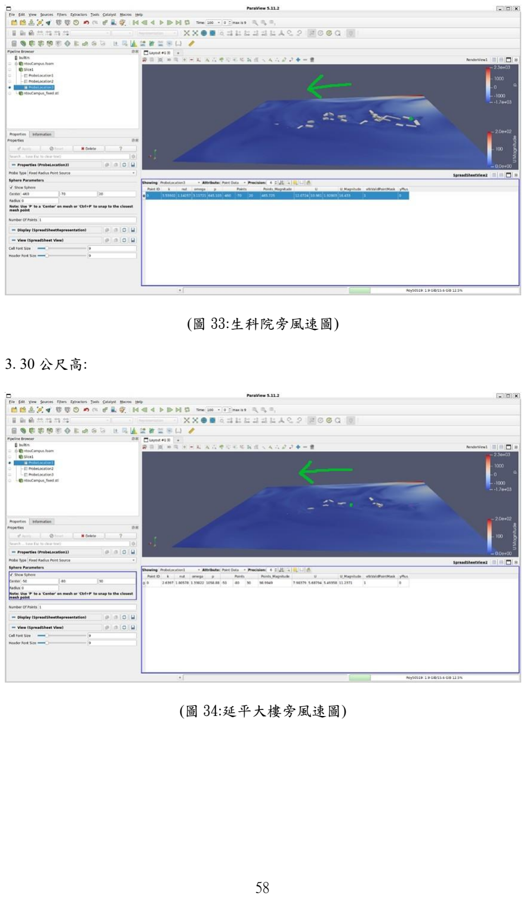
[picture p27: page 58]

### (圖 33:生科院旁風速圖)

3. 30 公尺高:

### (圖 34:延平大樓旁風速圖)

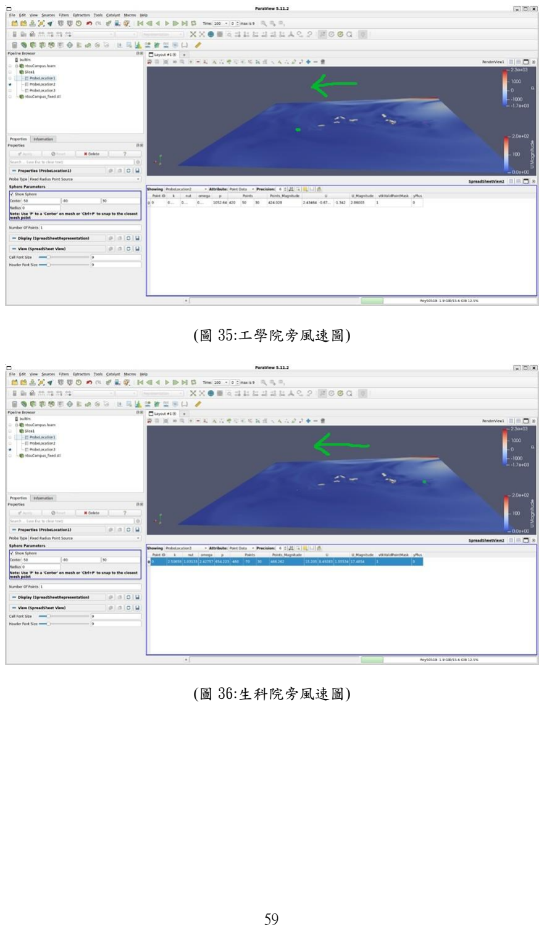
[picture p28: page 59]

### (圖 35:工學院旁風速圖)

### (圖 36:生科院旁風速圖)

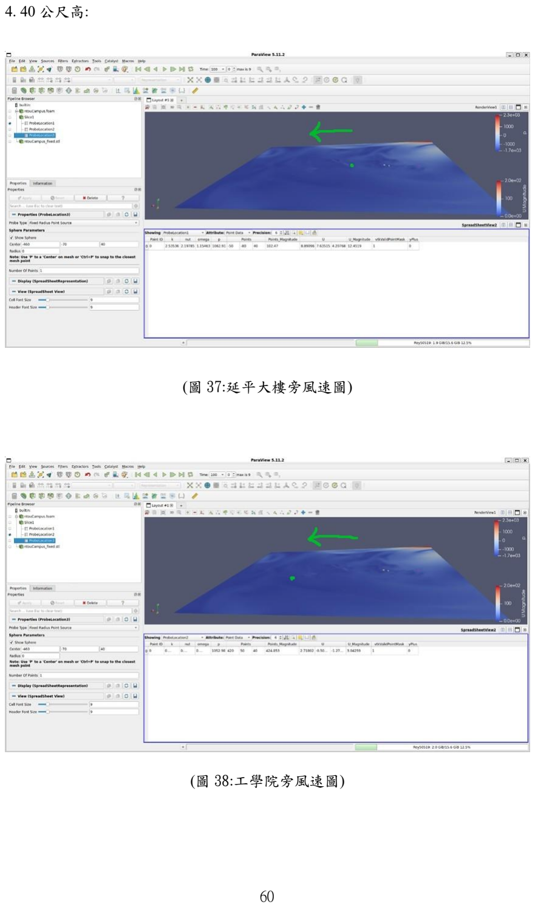
[picture p29: page 60]

4. 40 公尺高:

### (圖 37:延平大樓旁風速圖)

### (圖 38:工學院旁風速圖)

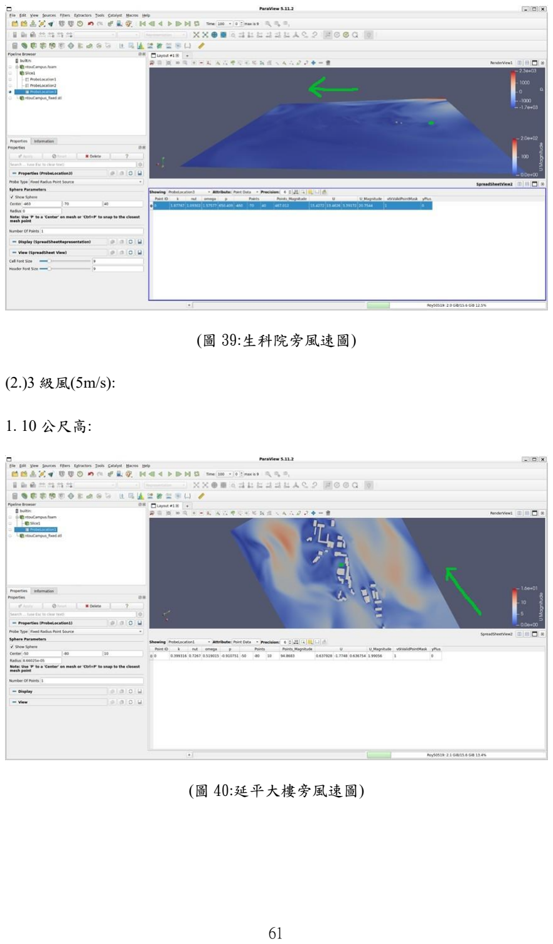
[picture p30: page 61]

### (圖 39:生科院旁風速圖)

(2.)3 級風(5m/s):

1. 10 公尺高:

### (圖 40:延平大樓旁風速圖)

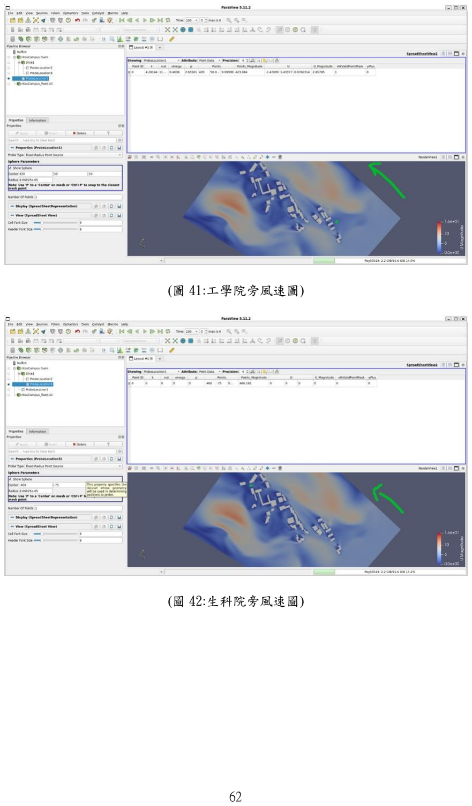
[picture p31: page 62]

### (圖 41:工學院旁風速圖)

### (圖 42:生科院旁風速圖)

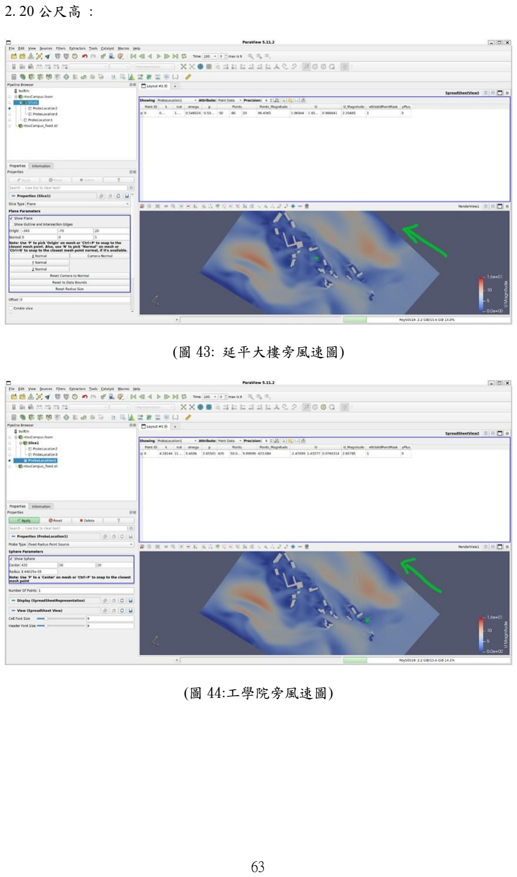
[picture p32: page 63]

2. 20 公尺高 :

### (圖 43: 延平大樓旁風速圖)

### (圖 44:工學院旁風速圖)

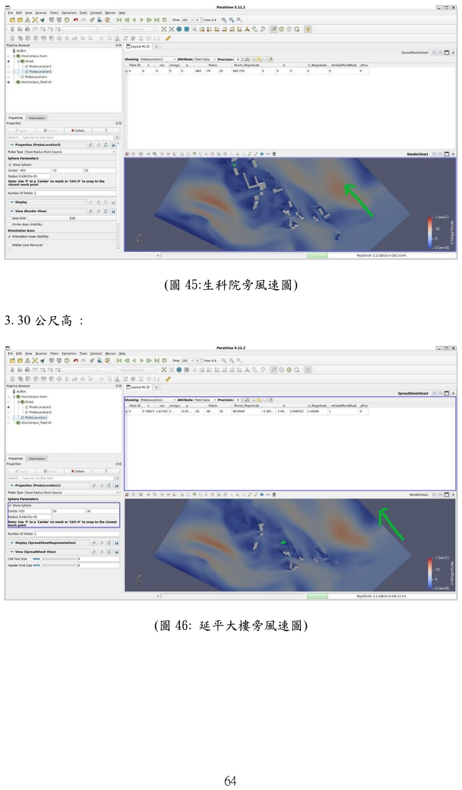
[picture p33: page 64]

### (圖 45:生科院旁風速圖)

3. 30 公尺高 :

### (圖 46: 延平大樓旁風速圖)

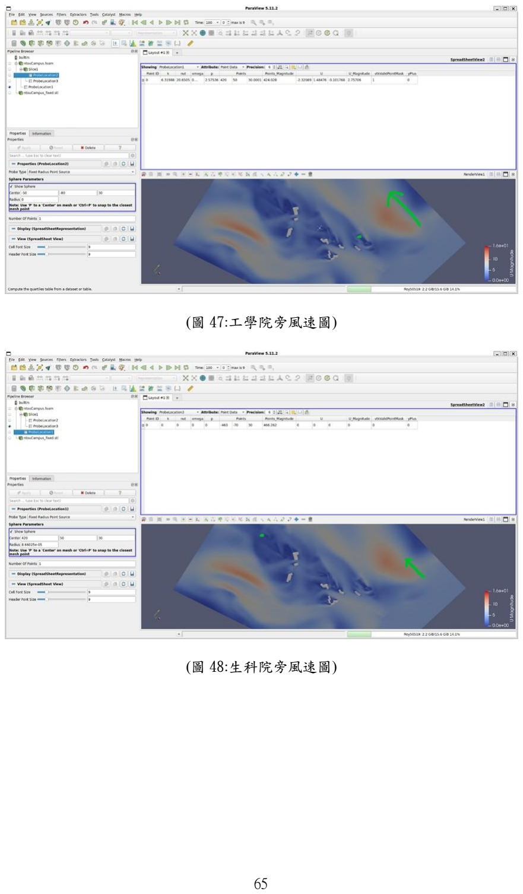
[picture p34: page 65]

### (圖 47:工學院旁風速圖)

### (圖 48:生科院旁風速圖)

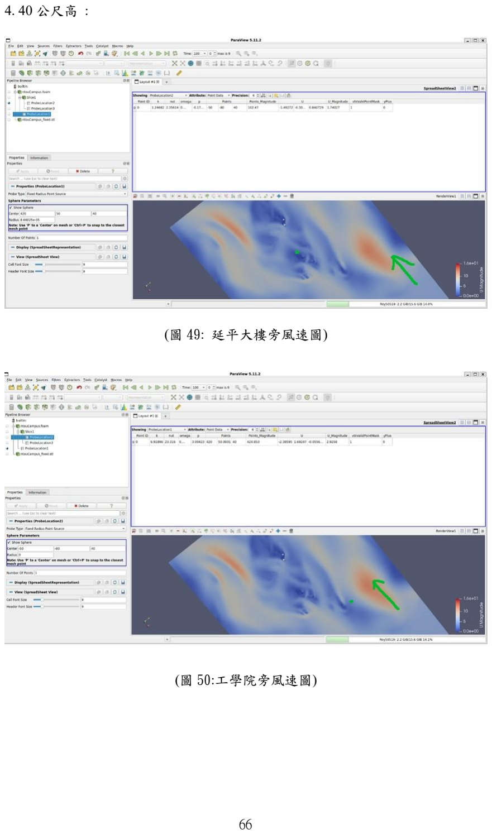
[picture p35: page 66]

4. 40 公尺高 :

### (圖 49: 延平大樓旁風速圖)

### (圖 50:工學院旁風速圖)

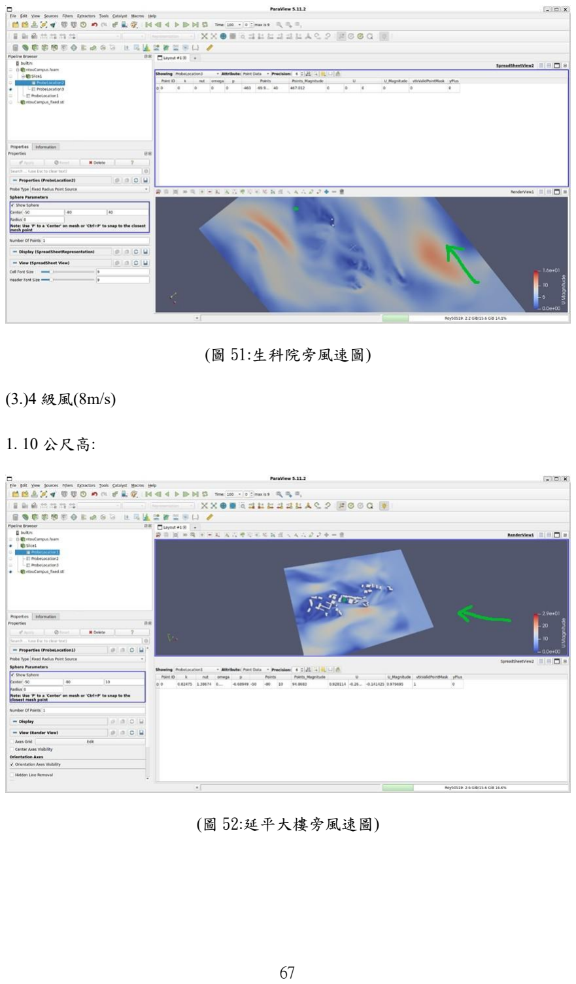
[picture p36: page 67]

### (圖 51:生科院旁風速圖)

(3.)4 級風(8m/s)

1. 10 公尺高:

### (圖 52:延平大樓旁風速圖)

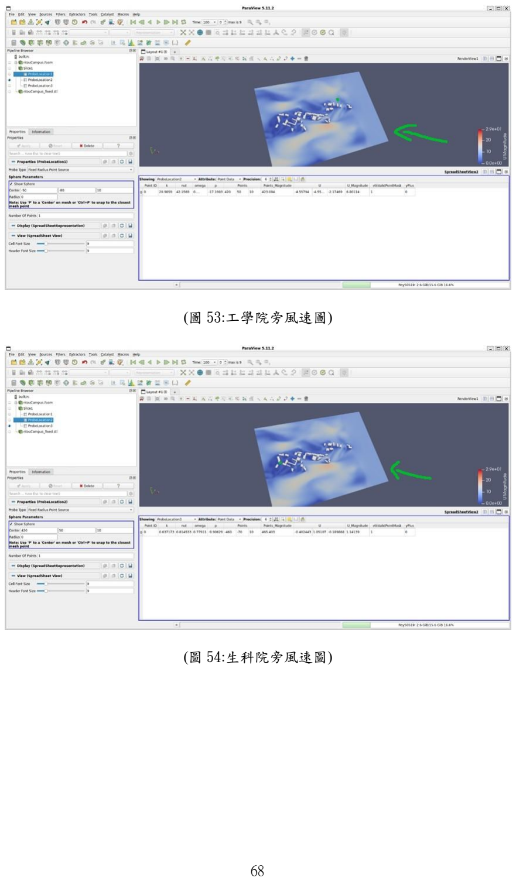
[picture p37: page 68]

### (圖 53:工學院旁風速圖)

### (圖 54:生科院旁風速圖)

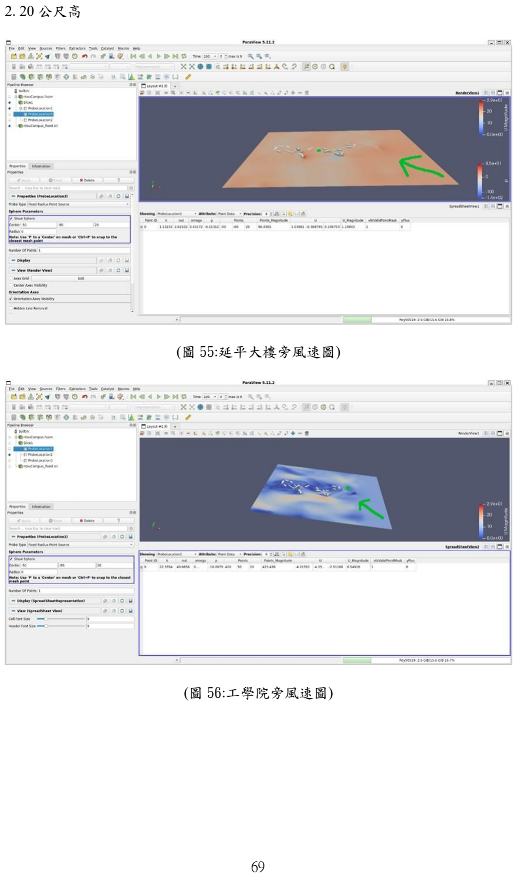
[picture p38: page 69]

2. 20 公尺高

### (圖 55:延平大樓旁風速圖)

### (圖 56:工學院旁風速圖)

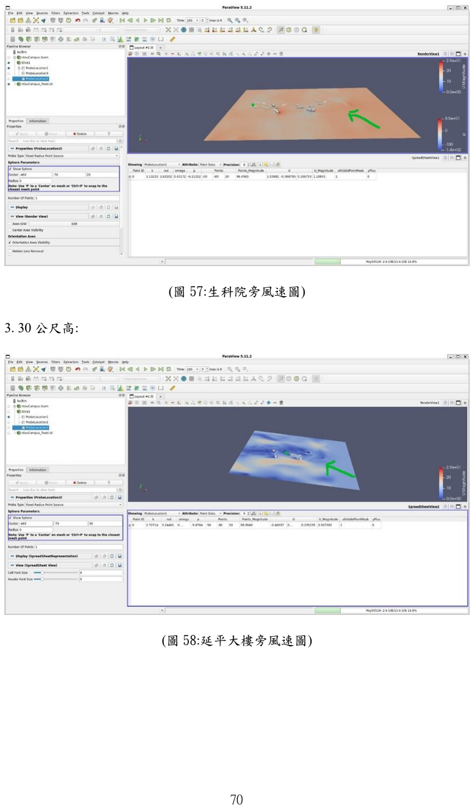
[picture p39: page 70]

### (圖 57:生科院旁風速圖)

3. 30 公尺高:

### (圖 58:延平大樓旁風速圖)

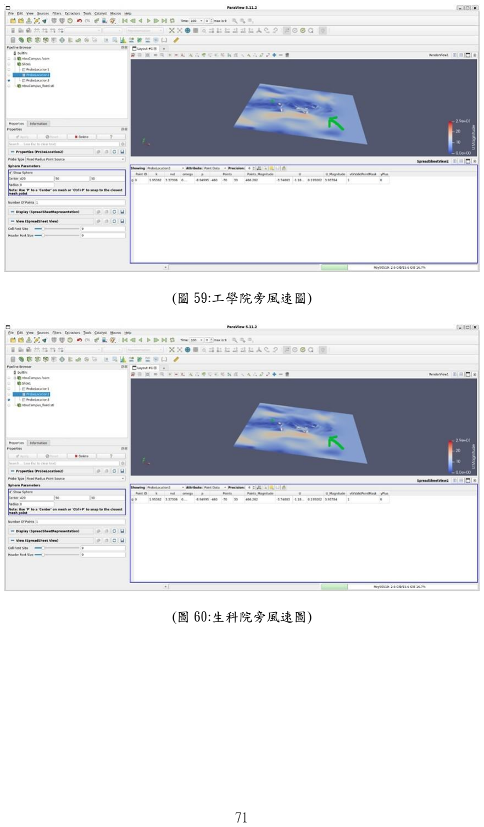
[picture p40: page 71]

### (圖 59:工學院旁風速圖)

### (圖 60:生科院旁風速圖)

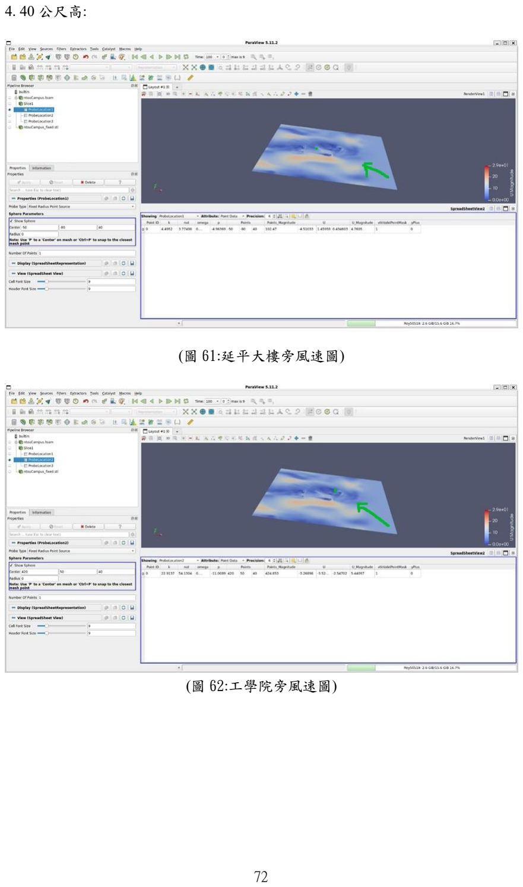
[picture p41: page 72]

4. 40 公尺高:

### (圖 61:延平大樓旁風速圖)

### (圖 62:工學院旁風速圖)

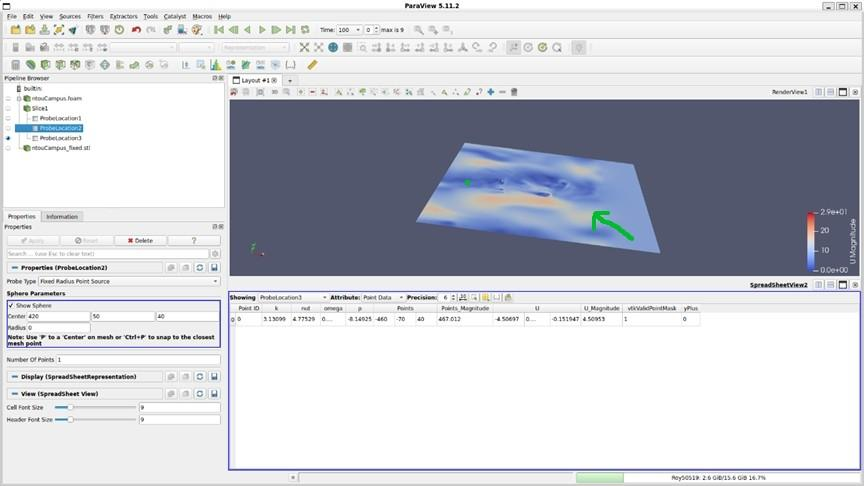
[picture p42: figure]

### (圖 63:生科院旁風速圖)

## 4.2 無人機實測數據整理與處理

### 本小節旨在展示經過 3.3 節中平均化處理後的實測數據品質，並分析三種工況

### 下的風場特性，以確立數據的統計信賴度。

## 4.2.1 實測數據品質與可重複性分析

### 以下是以無人機收集到的最終平均風速與標準差(表 3-表 5):

(1.) 數據彙總:

1. 2 級風(東北風):
風速及最終標準差 | 延平大樓旁 | 工學院旁 | 生科院旁
10 公尺 | 1.28 m/s、0.265 | 3.11 m/s、0.270 | 0.77 m/s、0.215
20 公尺 | 1.55 m/s、0.485 | 3.57 m/s、0.471 | 1.89 m/s、0.221
30 公尺 | 2.37 m/s、0.326 | 4.23 m/s、0.358 | 2.69 m/s、0.217
40 公尺 | 2.54 m/s、0.257 | 5.21 m/s、0.488 | 2.58 m/s、0.173

### (表 3：2 級風數據表)

2. 3 級風(北風):
風速及最終標準差 | 延平大樓旁 | 工學院旁 | 生科院旁

10 公尺 | 2.47 m/s、0.248 | 4.23 m/s、0.293 | 1.3 m/s、0.177
20 公尺 | 2.71 m/s、0.316 | 5.12 m/s、0.341 | 4.1 m/s、0.214
30 公尺 | 4.14 m/s、0.233 | 6.57 m/s、0.313 | 4.2 m/s、0.238
40 公尺 | 4.93 m/s、0.264 | 5.98 m/s、0.426 | 4.83 m/s、0.220

### (表 4：3 級風數據表)

3. 4 級風(東風):
風速及最終標準差 | 延平大樓旁 | 工學院旁 | 生科院旁
10 公尺 | 3.22 m/s、0.213 | 5.05 m/s、0.271 | 2.1 m/s、0.134
20 公尺 | 4.31 m/s、0.247 | 7.64 m/s、0.318 | 5.23 m/s、0.158
30 公尺 | 5.92 m/s、0.311 | 9.03 m/s、0.429 | 6.34m/s、0.193
40 公尺 | 7.58 m/s、0.286 | 7.66 m/s、0.367 | 7.22 m/s、0.241

### (表 5：4 級風數據表)

### 4.實地實測照:

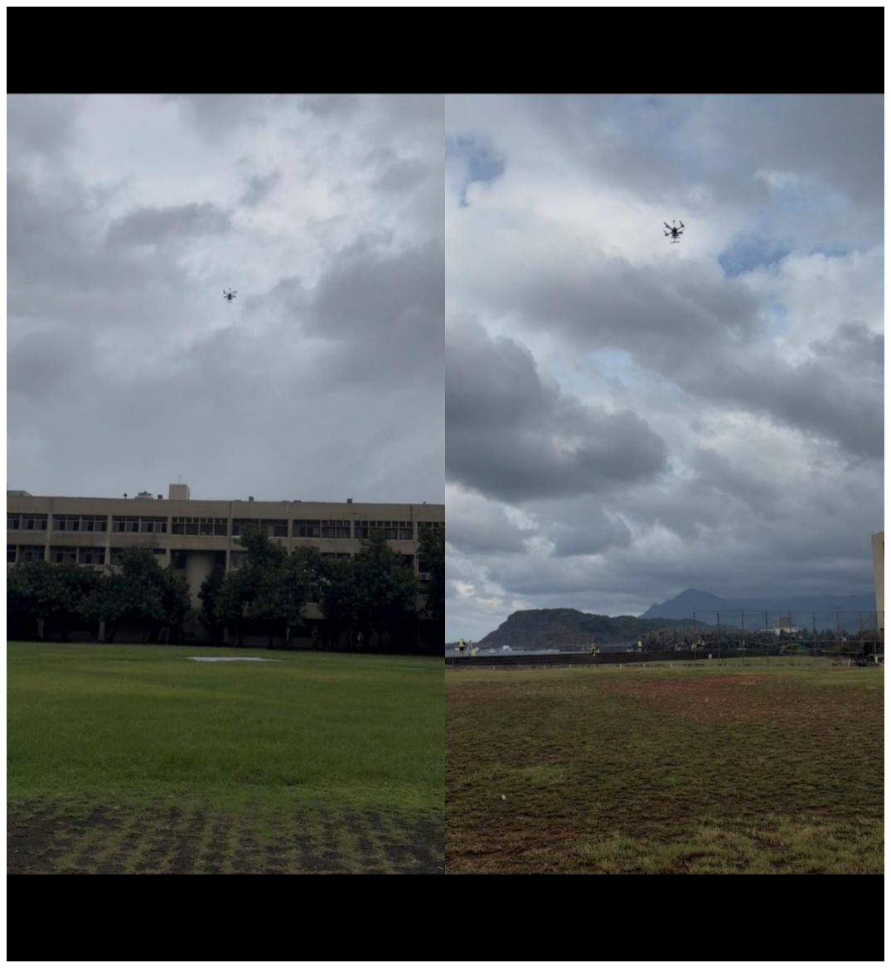
[picture p43: figure]

### (圖 64:延平大樓旁及工學院實測照片)

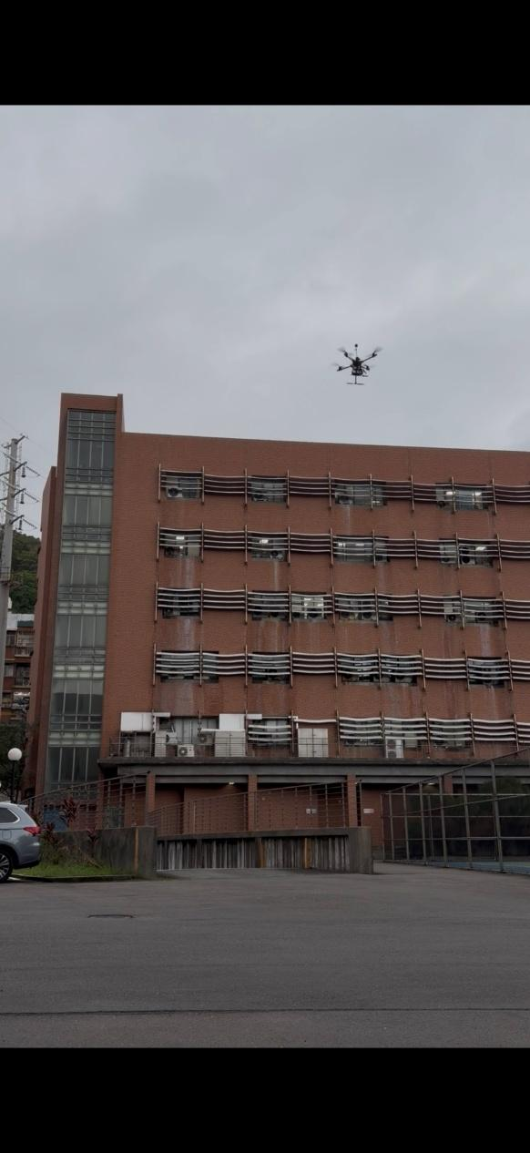
[picture p44: figure]

### (圖 65:生科院實測照片)

### (2.) 實測風場特性分析：

### - 數據分析顯示，最終標準差隨著風速工況上升呈現明顯增長趨勢。這項

### 趨勢與大氣邊界層中紊流強度隨風速增強而增加的物理特性一致。這證

### 明了無人機感測器系統有效地捕捉了風場的自然波動 (紊流)。

### - 垂直剖面趨勢：

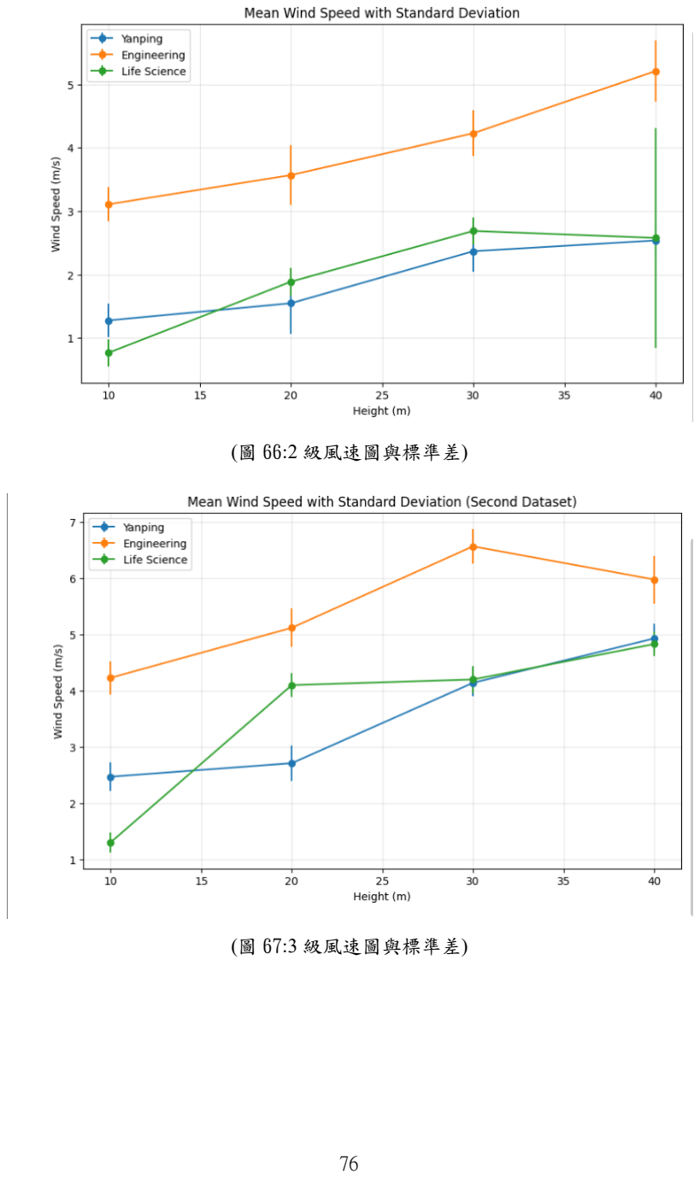
[picture p45: page 76]

### (圖 66:2 級風速圖與標準差)

### (圖 67:3 級風速圖與標準差)

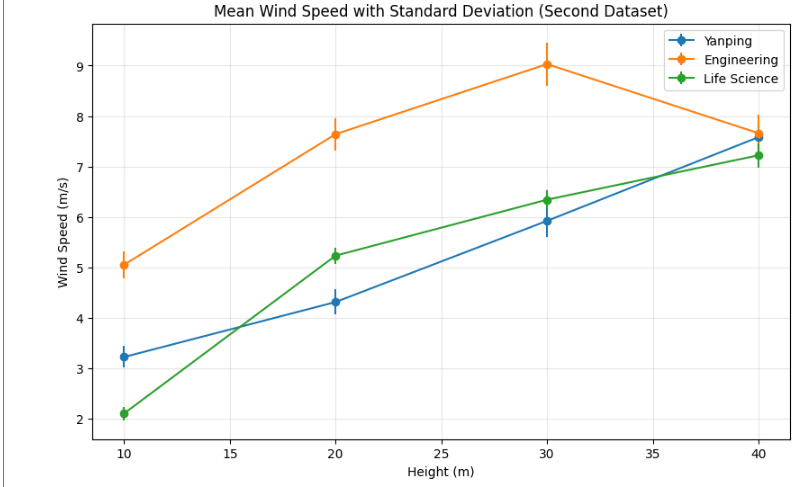
[picture p46: figure]

### (圖 68:4 級風速圖與標準差)

## 4.3 模擬與實測數據的定量對比

### 本小節旨在透過定量誤差指標 RMSE 與 R，驗證 OpenFOAM 搭配k −

### ω SST 模型在 2 級、3 級、 4 級風三種工況下的預測精度。所有實測數據均經

### 過 3.3 節所述的平均化處理。

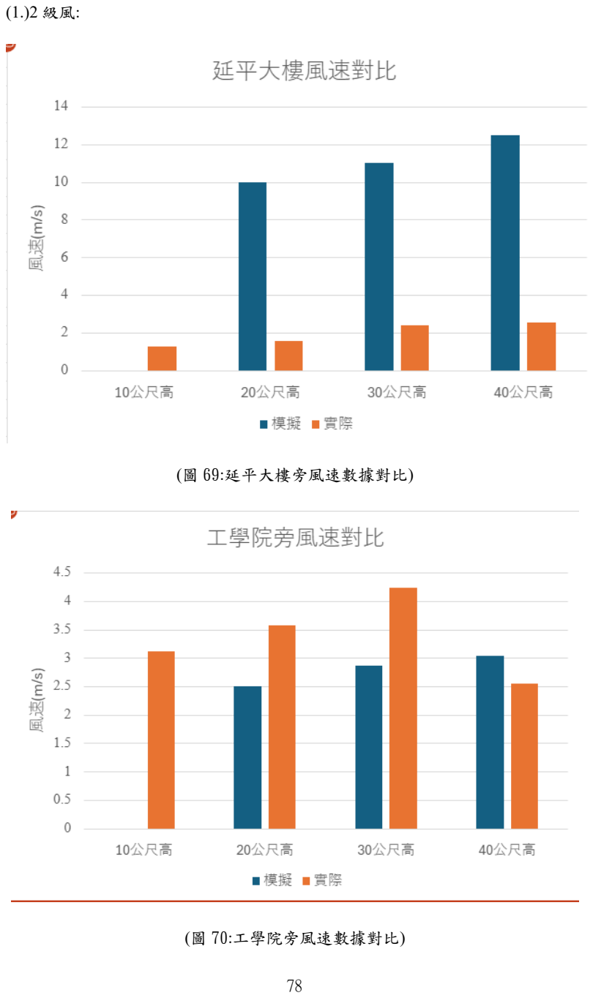
[picture p47: page 78]

(1.)2 級風:

### (圖 69:延平大樓旁風速數據對比)

### (圖 70:工學院旁風速數據對比)

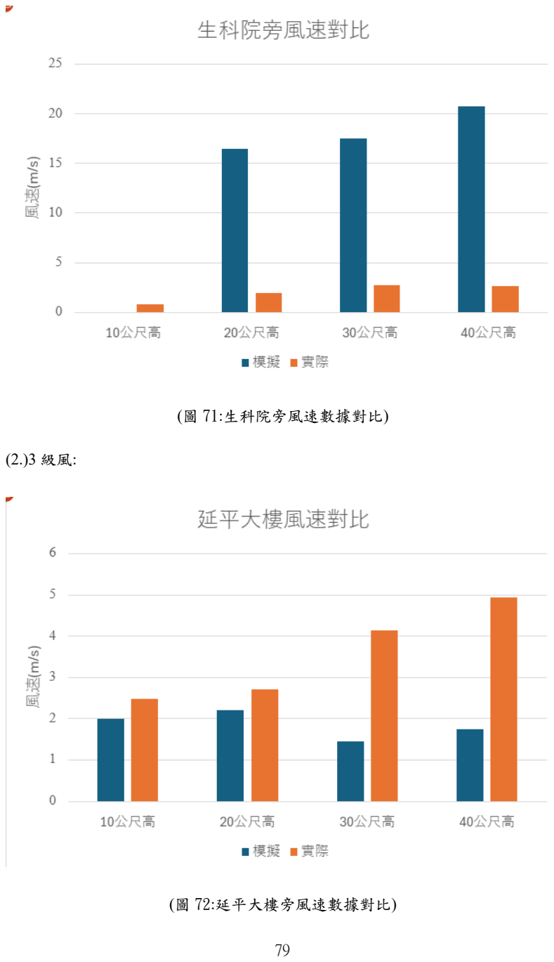
[picture p48: page 79]

### (圖 71:生科院旁風速數據對比)

(2.)3 級風:

### (圖 72:延平大樓旁風速數據對比)

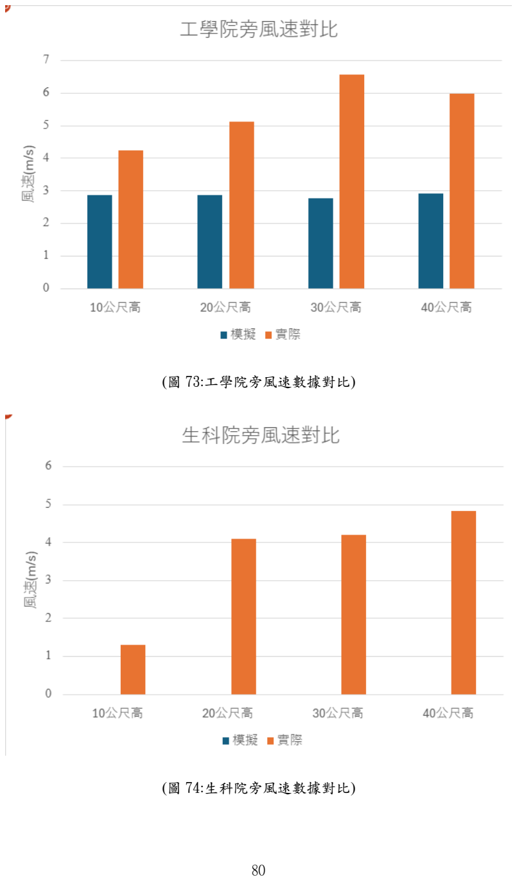
[picture p49: page 80]

### (圖 73:工學院旁風速數據對比)

### (圖 74:生科院旁風速數據對比)

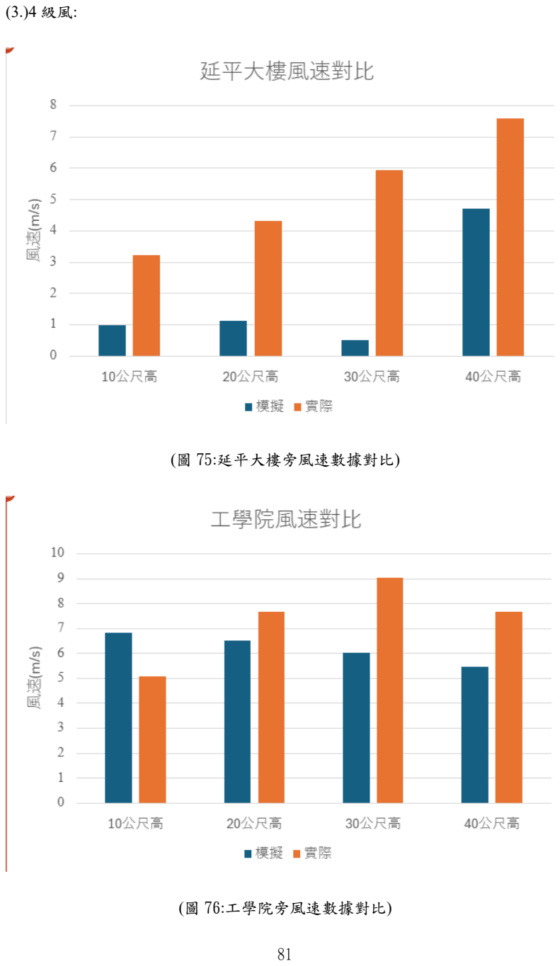
[picture p50: page 81]

(3.)4 級風:

### (圖 75:延平大樓旁風速數據對比)

### (圖 76:工學院旁風速數據對比)

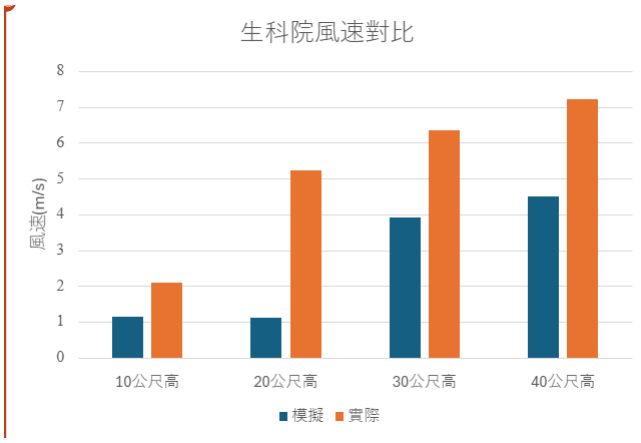
[picture p51: figure]

### (圖 77:生科院旁風速數據對比)

## 4.4 實驗結果之檢討與建議

### 實驗結果發現，雖然 CFD 模擬與實測數據整體趨勢一致，但在建築群密集區

### 域及低風速條件下出現明顯偏差，因此有必要檢討模擬模型、測量方法及相關

### 假設，並提出後續改進方向。

(1.) 模擬方面:

### 因為硬體設備限制，紊流模型的 yPlus 數值相當高，導致在建築群周圍模

### 擬出的風速跟實際的差距不小，並且簡化周圍環境也容易導致局部風速偏

### 差擴大，未來在模擬時可以選購更好的設備進行模擬計算以解決這個問

題。

(2.) 實測方面:

### 由於時間關係，本實驗無法獲得更多的實測樣本，無論是地點抑或是次數都偏

### 少，樣本過少可能導致無法很好的反應真實結果，並且 Pixhawk 4 GPS 模組本

### 身只帶有一個氣壓計，導致內建的氣壓計毀壞之後無人機會不受控制，甚至墜

### 毀，未來再做實測時建議能用新型的 Pixhawk 6 GPS 模組，其本身內建兩個氣

### 壓計，可以更好的避免無人毀壞問題。

## 第五章 結論

### 本實驗結合 Blender 幾何建模、OpenFOAM 數值模擬與無人機多工況實

### 測，旨在驗證 CFD 模擬模型與 Windy 軟體的風速預測精確度。結果顯示，

### CFD 模擬在初始風速過小時會有極大的偏差，不過整體趨勢與實測風速高度分

### 布相符，但整體數值會小於實際結果，並且在建築物群之中時，數值會下降的

### 更多，整體平均偏差落在 30%-40%，我們猜測是由於硬體限制導致模擬無法在

### 建築周圍用紊流模型很好的模擬整體風速、風向狀況，數據表明 CFD 模擬模

### 型對建築物周邊風速的預測較為困難，但可以得知周圍風向流動，而高度越高

### 時實際數值會越來越接近 Windy 軟體所預測的風速，整體而言，CFD 模型可以

### 提供預測跟模擬，不過要注意風速數值的偏差，而 Windy 軟體則適合高空(40

### 公尺以上)或空地的風速估算，兩者可配合使用，以提升精確度。

## 第六章 參考資料

### [1] 超音波風速風向儀用戶使用手冊(紙本)

[2] TAIWANIOT 網站，ESP-32S 規格資料：

https://www.taiwaniot.com.tw/product/nodemcu-esp-

32s/?srsltid=AfmBOoo_hMrojUPosTF0vkJ2QTVEYjIizKfUIb4y2Y8FMPnDgSCwE

-ck (https://www.taiwaniot.com.tw/product/nodemcu-esp-32s/)

[3]TAIWANIOT 網站，RS-485 模組規格資料：

https://www.taiwaniot.com.tw/product/%E5%96%AE%E7%89%87%E6%A9%9F-

ttl%E8%BD%89rs485%E6%A8%A1%E7%B5%84-

485%E8%BD%89%E4%B8%B2%E5%8F%A3uart%E9%9B%BB%E5%B9%B3%E

4%BA%92%E8%BD%89/?srsltid=AfmBOorHN2OmkhHFwERAewhXJ8movpUTr7

Pff5R-LPJm9NSfo53xiOTQ (https://www.taiwaniot.com.tw/product/%E5%96%AE%E7%89%87%E6%A9%9F-ttl%E8%BD%89rs485%E6%A8%A1%E7%B5%84-485%E8%BD%89%E4%B8%B2%E5%8F%A3uart%E9%9B%BB%E5%B9%B3%E4%B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)

[4]TAIWANIOT 網站，Raspberry Pi 5 規格資料：

https://www.taiwaniot.com.tw/product/raspberry-pi-5-model-b-4g/

### [5]ArduPilot 官方網站，各種校正條參說明：

https://ardupilot.org/copter/index.html

[6]ESP-32S 使用教學：

https://blog.jmaker.com.tw/arduino-ide-esp32/

[7] Segersson D. A tutorial to urban wind flow using OpenFOAM. In: Proceedings of CFD with OpenSource Software. 2017. p. 1-28. (佐證 Blender 軟體優勢與

OpenFOAM 城市流動應用)

[8] vvoovv. blosm - Blender OpenStreetMap [computer software]. Available from: https://github.com/vvoovv/blosm. Accessed 2024 Nov 17. (佐證衛星數據獲取插件

blosm 的使用)

[9] Blocken B, Gualtieri C. A review of pollutant dispersion around isolated buildings

in the urban environment: CFD modelling and wind tunnel experiments. Environ Pollut. 2009;157(10):2965-2977. (佐證模型簡化原則)

[10] Simularge Blog. Preparing CAD Geometry for CFD Simulations: Essential Steps

and Best Practices. Simularge; 2025. Available from:

https://www.simularge.com/blog/preparing-cad-geometry-for-cfd-simulations-essential-steps-and-best-practices. (https://www.simularge.com/blog/preparing-cad-geometry-for-cfd-simulations-essential-steps-and-best-practices) Accessed 2024 Nov 17. (佐證幾何修復消除非流

### 形邊緣，解決網格爆點問題)

[11] Tominaga Y, Mochida A. CFD prediction of pedestrian wind environment around

buildings: a review and practical recommendations. J Wind Eng Ind Aerodyn. 2011;99(10):349-361. (佐證網格生成的重要性，以及 CFD 最佳實踐規範)

[12] Richards DJ, Stansby PK. Computational fluid dynamics prediction of

pedestrian-level winds: a review of best practice and validation methods. J Wind Eng Ind Aerodyn. 2018;176:216-228. (佐證網格品質指標，如最大非正交性的接受標 準)

[13] Menter FR. Two-Equation Eddy-Viscosity Turbulence Models for Engineering Applications. AIAA Journal. 1994;32(8):1598-1605. (k − ω SST 模型原始論文，佐

### 證其優勢)

[14] Blocken B. Computational Fluid Dynamics (CFD) for urban physics: A review. J Wind Eng Ind Aerodyn. 2015;147:1-35. (佐證 k − ε SST 等其他紊流模型在城市

### CFD 應用中的優勢與限制，以支持 k − ω SST 的選擇)

[15] Pope SB. Turbulent Flows. 1st ed. Cambridge University Press; 2000. (紊流理論

### 經典專著，佐證紊流動能 k 和耗散率 ω 的初始值公式計算)

[16] Taylor JR. An Introduction to Error Analysis: The Study of Uncertainties in Physical Measurements. 2nd ed. University Science Books; 1997. (佐證最終標準差

### 作為實驗可重複性的統計指標)

附錄

1. ESP-32S 開發板內的程式碼(使用 Arduino IDE 進行程式撰寫及燒錄)

### 完整程式碼：

#include <ModbusMaster.h>

// ====== 物件與腳位設定 ======

ModbusMaster node;

#define RE_DE 4 | // RS485 模組 DE/RE 腳位

#define TXD2 17 | // ESP32 UART2 TX

#define RXD2 16 | // ESP32 UART2 RX

// RS485 傳輸前/後的方向控制

void preTransmission() { digitalWrite(RE_DE, HIGH); }

void postTransmission() { digitalWrite(RE_DE, LOW); }

void setup() {

Serial.begin(115200); // 與樹莓派通訊

Serial2.begin(9600, SERIAL_8E1, RXD2, TXD2); // 與風速計通訊：9600,

8E1

node.begin(1, Serial2); // Modbus ID = 1

pinMode(RE_DE, OUTPUT);

digitalWrite(RE_DE, LOW); // 預設為接收狀態

node.preTransmission(preTransmission);

node.postTransmission(postTransmission);

delay(1000);

Serial.println("✅ ESP32 風速計啟動完成，開始傳送資料...");

}

void loop() {

float spd = NAN;

float dir = NAN;

// ====== 讀取風向（地址 0x0001, 寄存器數量 1）======

uint8_t result_dir = node.readHoldingRegisters(0x0001, 1);

if (result_dir == node.ku8MBSuccess) {

dir = node.getResponseBuffer(0);

}

// ====== 讀取風速（地址 0x0002, 寄存器數量 2）======

uint8_t result_spd = node.readHoldingRegisters(0x0002, 2);

if (result_spd == node.ku8MBSuccess) {

uint16_t high_word = node.getResponseBuffer(0);

uint16_t low_word = node.getResponseBuffer(1);

// 正確順序：低位在前

union {

uint32_t i;

float f;

} u;

u.i = ((uint32_t)low_word << 16) | high_word;

spd = u.f;

}

// ====== 防呆與輸出 JSON ======

if (!isnan(spd) && !isnan(dir)) {

Serial.printf("{\"spd\":%.2f,\"dir\":%.1f}\n", spd, dir); // 標準

JSON

} else {

Serial.println("{\"spd\":0,\"dir\":0}"); // 若讀取失敗則回傳 0

}

delay(1000); // 每秒輸出一次

}

2. Raspberry Pi 風速風向資料處理與 Flask 伺服器程式碼

### 程式碼：

# ==============================

# 風速風向 Flask Server（完整穩定版）

# ==============================

from flask import Flask, render_template, jsonify

import serial, json, time, csv, os, threading, socket

from datetime import datetime

app = Flask(__name__)

# ---------- 串口設定 ----------

# 依你目前環境：ESP32 用 /dev/ttyUSB0，115200

# 若不同可改成 /dev/ttyACM0 或 Windows 的 COMx

SERIAL_PORT = os.environ.get("WIND_SERIAL", "/dev/ttyUSB0")

BAUD = 115200

ser = None

def _open_serial():

global ser

try:

ser = serial.Serial(SERIAL_PORT, BAUD, timeout=1) print(f"✅ Serial opened on {SERIAL_PORT} @ {BAUD}")

except Exception as e:

ser = None

print(f"❌ Serial open failed: {e}")

_open_serial()

# ---------- 全域資料 ----------

last_data = {"spd": 0.0, "dir": 0.0}

samples = []

data_lock = threading.Lock()

# ---------- 工具：取得本機 IP ----------

def get_ip():

try:

s = socket.socket(socket.AF_INET, socket.SOCK_DGRAM)

s.connect(("8.8.8.8", 80))

ip = s.getsockname()[0]

s.close()

return ip

except:

return "127.0.0.1"

# ---------- 感測資料讀取（單筆） ----------

def read_one():

global last_data, ser if ser is None or not ser.is_open:

_open_serial()

return

try:

line = ser.readline().decode("utf-8", errors="ignore").strip()

if not line:

return

# 僅接受完整 JSON

if not (line.startswith("{") and line.endswith("}")):

# print("⚠️ 忽略不完整資料:", line)

return

d = json.loads(line)

if "spd" in d and "dir" in d:

with data_lock:

last_data = {"spd": float(d["spd"]), "dir": float(d["dir"])}

samples.append(last_data)

# else:

# print("⚠️ JSON 缺少欄位:", d)

except json.JSONDecodeError:

# print("❌ JSON decode failed:", line)

pass

except Exception as e:

print("❌ read_one error:", e)

# ---------- 每分鐘平均存檔 ----------

def save_average():

global samples

with data_lock:

if not samples:

return

avg_spd = sum(d["spd"] for d in samples) / len(samples)

avg_dir = sum(d["dir"] for d in samples) / len(samples)

samples = []

if not os.path.exists("data"):

os.makedirs("data")

filename = f"data/wind_{datetime.now().strftime('%Y-%m-%d')}.csv"

write_header = not os.path.exists(filename)

with open(filename, "a", newline="") as f:

w = csv.writer(f)

if write_header:

w.writerow(["timestamp", "avg_speed(m/s)",

"avg_direction(deg)"])

w.writerow([datetime.now().strftime("%Y-%m-%d %H:%M:%S"),

round(avg_spd, 2), round(avg_dir, 1)])

print(f"📦 Saved avg: {avg_spd:.2f} m/s, {avg_dir:.1f}°")

# ---------- 感測讀取背景執行緒 ----------

def sensor_loop():

last_save = time.time()

while True:

read_one()

if time.time() - last_save > 60:

save_average()

last_save = time.time()
time.sleep(0.02) # 50Hz 輕量輪詢

# ---------- Flask 路由 ----------

@app.route("/")

def index():

return render_template("index.html") # templates/index.html

@app.route("/data")

def data():

with data_lock:

d = dict(last_data)

return jsonify(d)

# ---------- 入口 ----------

if __name__ == "__main__":

ip = get_ip()

print(f"🌐 Open http://{ip}:5000 （你的 IP 是 {ip}，你提供的是

172.20.10.6 也可以）")

### # 啟動感測背景執行緒

threading.Thread(target=sensor_loop, daemon=True).start()

### # 啟動 Flask（對外可訪問）

app.run(host="0.0.0.0", port=5000, debug=False)

### 3. 超聲波風速風向儀風戶使用手冊重點截圖：

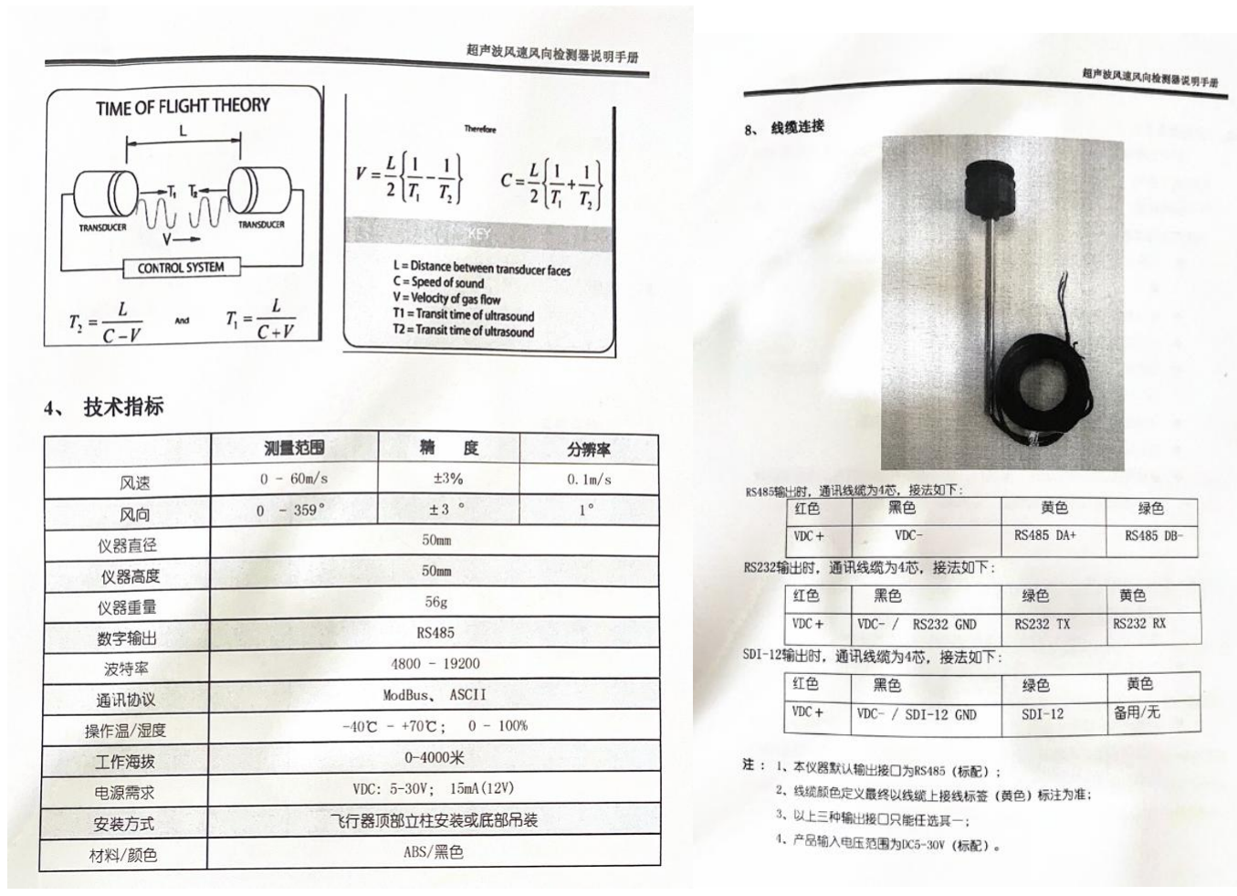
[picture p52: figure]
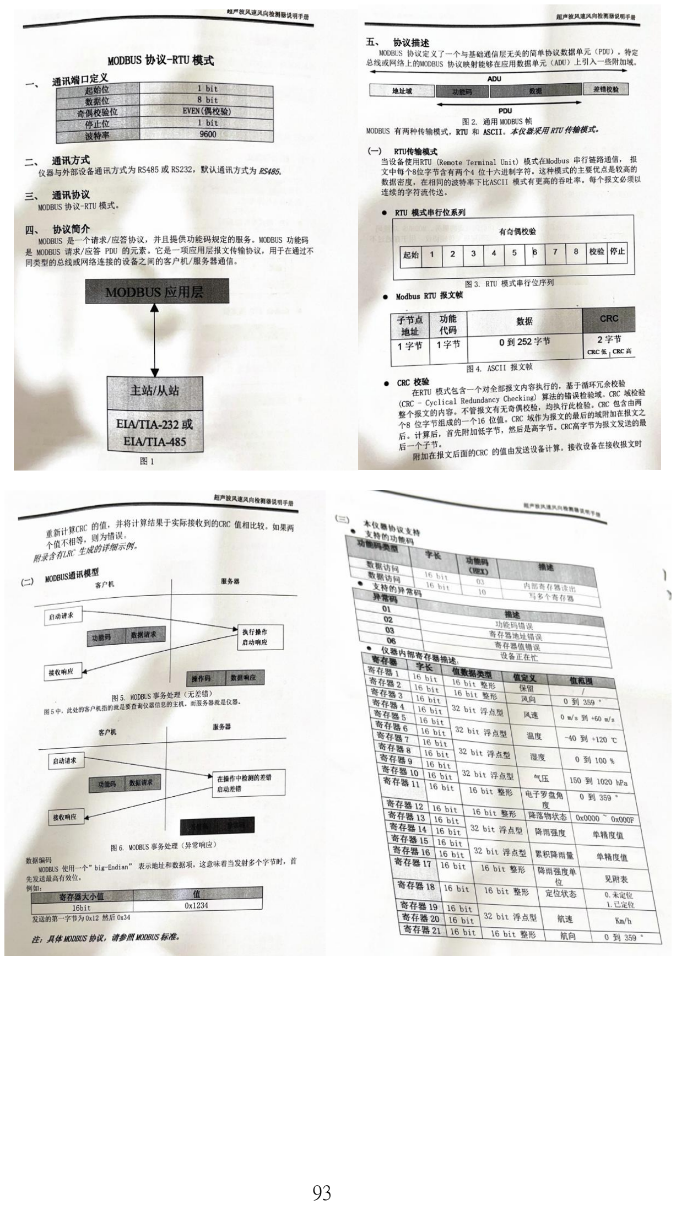
[picture p53: page 93]
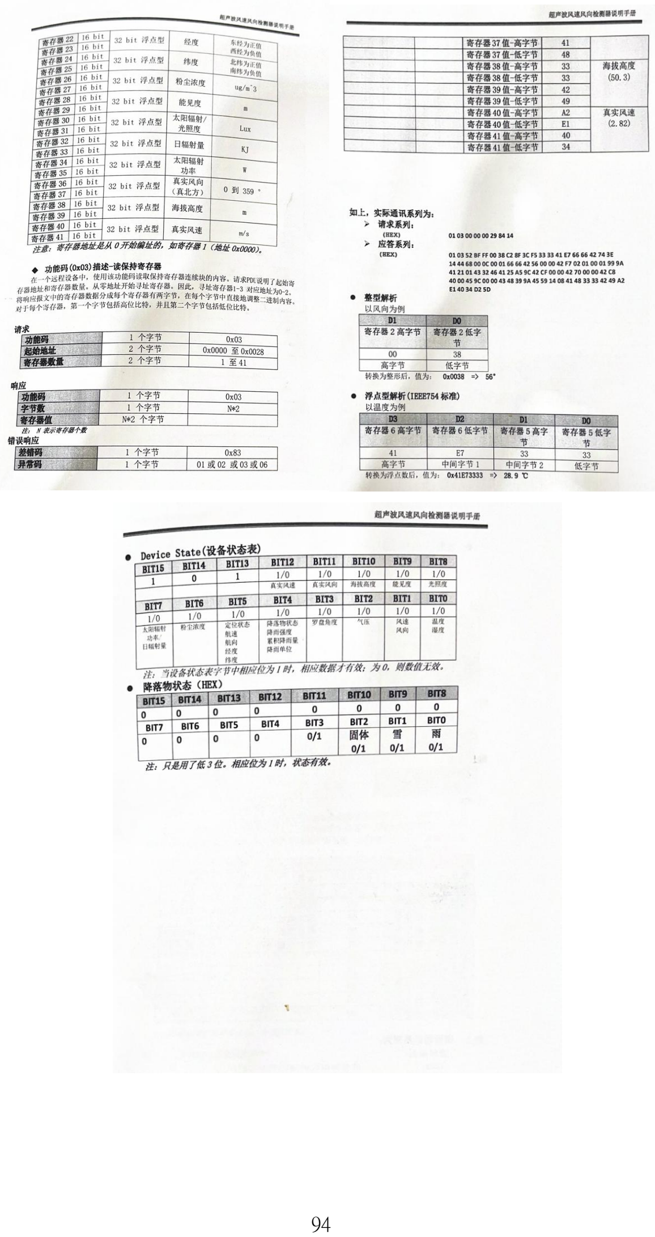
[picture p54: page 94]
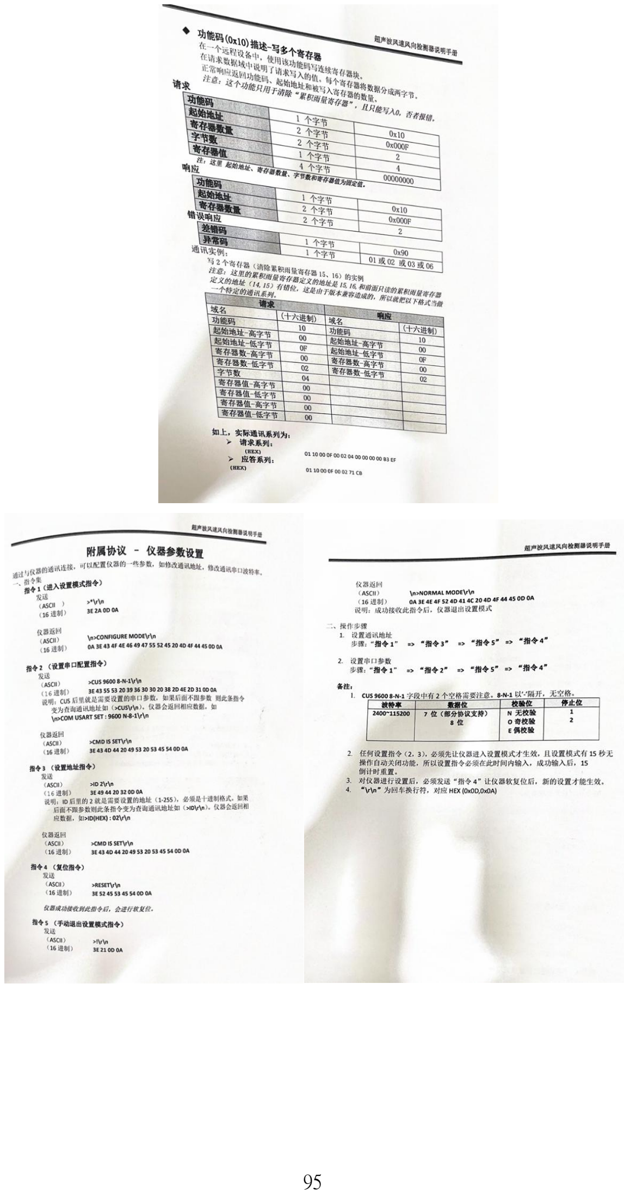
[picture p55: page 95]
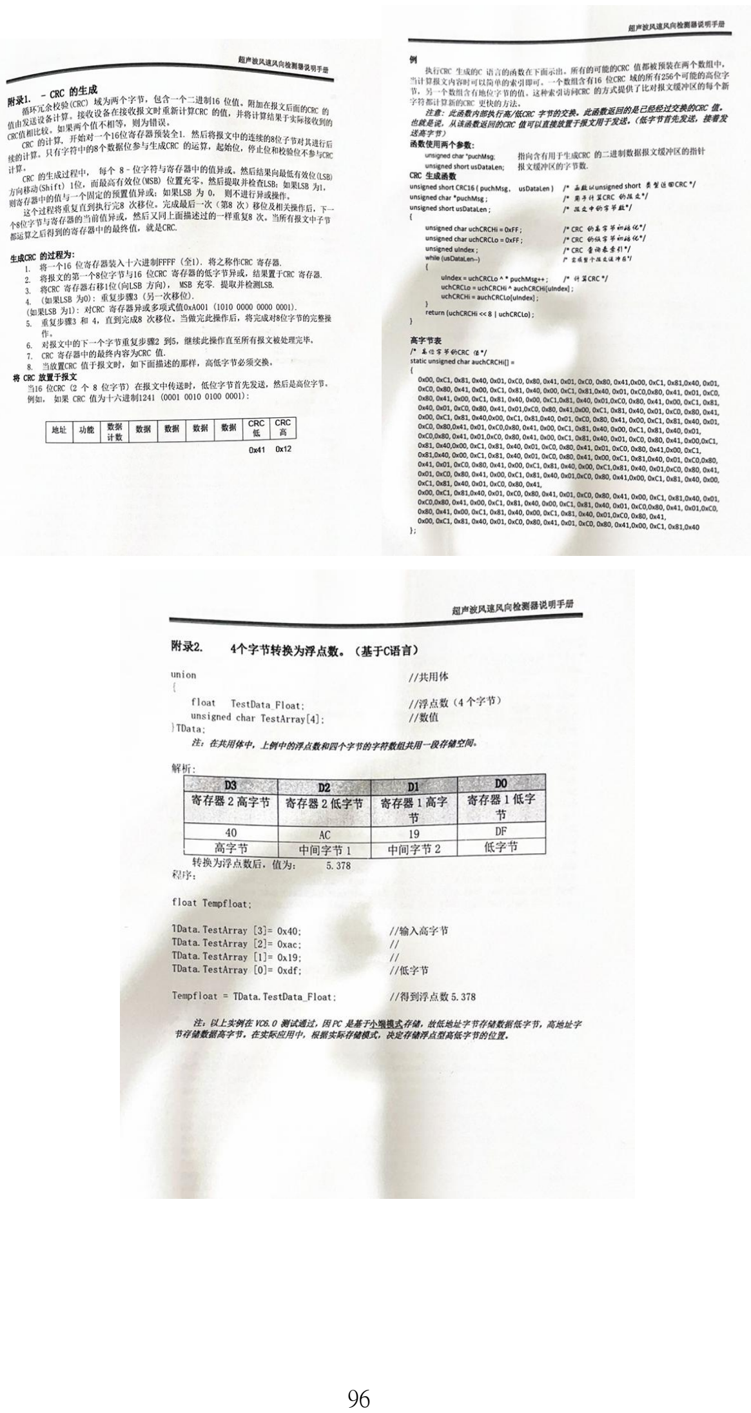
[picture p56: page 96]
