williamsu0707/NTOU-UAV-Wind-Measurement-System/UAV_Route_Planning/mission_outputs/ntou_rooftops.png

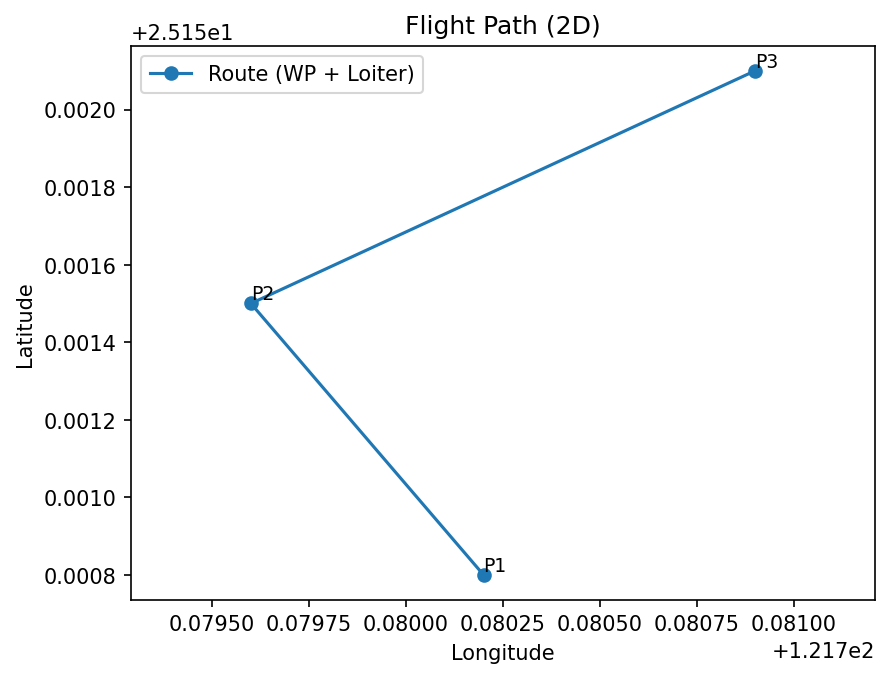
UAV_Route_Planning/mission_outputs/ntou_rooftops.png
