williamsu0707/NTOU-UAV-Wind-Measurement-System/UAV_Route_Planning/3d_maps_and_data/ntouCampus_fixed.stl

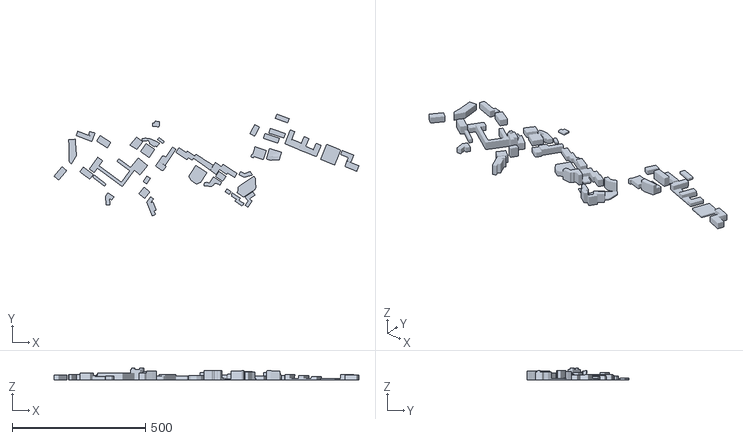
[picture p58: CAD file, 2026-10-19]
UAV_Route_Planning/3d_maps_and_data/ntouCampus_fixed.stl
1142.8 x 381.3 x 46.2
